kitspace/component_tester/playground/knopf-zelle/Material/besser_als_tischlein.jpg

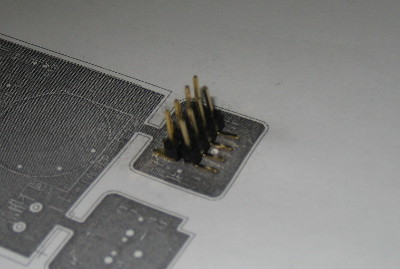
playground/knopf-zelle/Material/besser_als_tischlein.jpg
