kitspace/component_tester/playground/knopf-zelle/Material/Bilder/3top.jpg

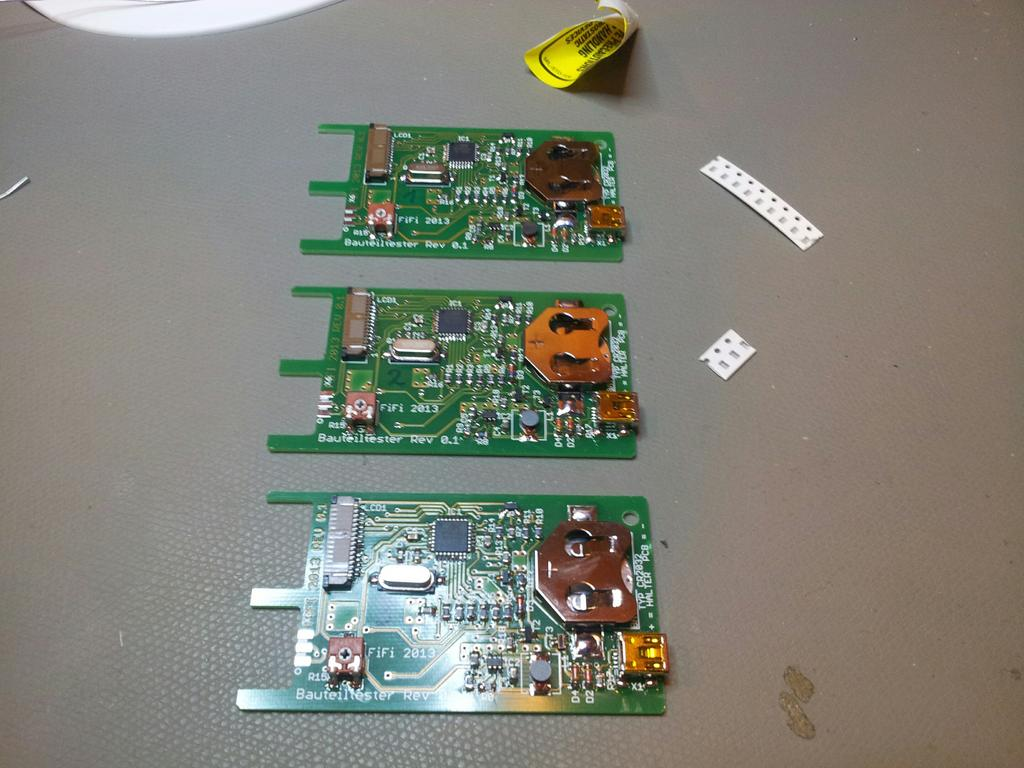
playground/knopf-zelle/Material/Bilder/3top.jpg
