kitspace/component_tester/playground/knopf-zelle/Datasheets/Fischer-SMD-Stiftleiste.jpg

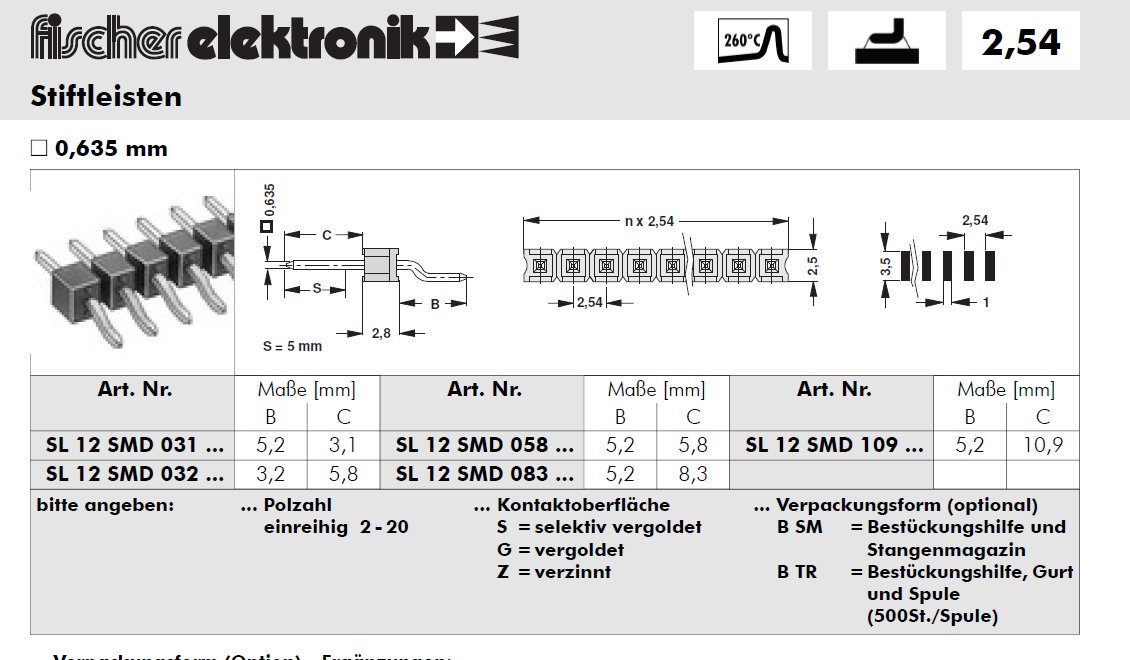
playground/knopf-zelle/Datasheets/Fischer-SMD-Stiftleiste.jpg
