kitspace/component_tester/playground/knopf-zelle/Datasheets/Pollin-Display G120386.JPG

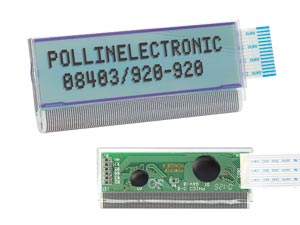
playground/knopf-zelle/Datasheets/Pollin-Display G120386.JPG
