kitspace/component_tester/playground/knopf-zelle/Gehaeuse/Gehaeuse_01.jpg

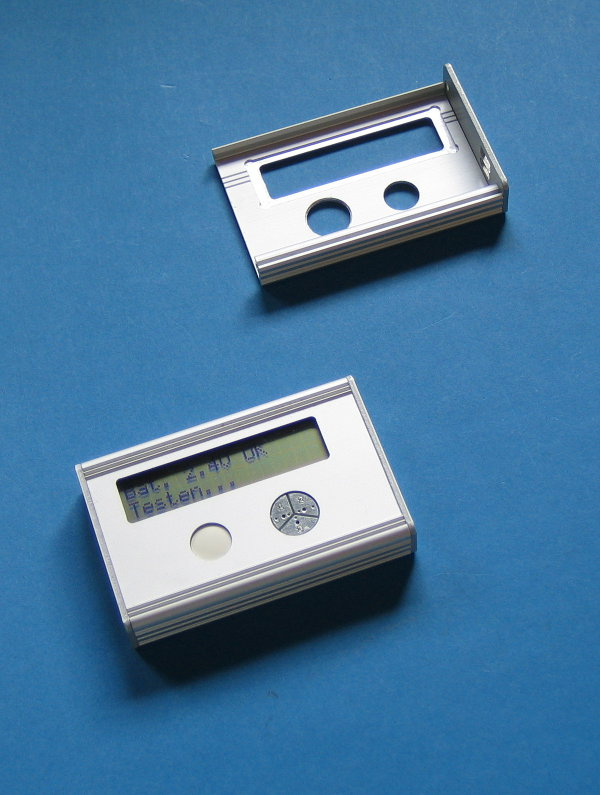
playground/knopf-zelle/Gehaeuse/Gehaeuse_01.jpg
