kitspace/component_tester/playground/knopf-zelle/Material/SMD_Teile.odt

Mini-Bauteiltester Aufbauanleitung: www.ov-lennestadt.de | | | | Mini-Bauteiltester Aufbauanleitung: www.ov-lennestadt.de
6x Varistor 3 pF | 2x 22 pF | 2x 100 nF | 1x 1 nF | 6x Varistor 3 pF | 2x 22 pF | 2x 100 nF | 1x 1 nF
1x 4,7 uF KER | 2x 4,7 uF TAN | 2x 47 uF KER | 1x LED | 1x 4,7 uF KER | 2x 4,7 uF TAN | 2x 47 uF KER | 1x LED
1x LM4040 | 2x 1N4148 | 1x BAS70-05 (C-C) | 1x BAS70-06 (C-A) | 1x LM4040 | 2x 1N4148 | 1x BAS70-05 (C-C) | 1x BAS70-06 (C-A)
1x 100R | 3x 680R 0,1% | 1x 3k3 | 7x 10k +1 | 1x 100R | 3x 680R 0,1% | 1x 3k3 | 7x 10k +1
1x 33k | 1x 68k | 1x 240k | | 1x 33k | 1x 68k | 1x 240k
3x 470k 0,1% | 1x 750k | 1x 1M | 1x 3M3 | 3x 470k 0,1% | 1x 750k | 1x 1M | 1x 3M3
1x BC847 | 1x BSS123 | 1x PMV65XP | 2x BSS84 | 1x BC847 | 1x BSS123 | 1x PMV65XP | 2x BSS84
Lose: Platine, Batteriehalter, Batterie CR2032, 100 uF TAN-D, MEGA 168, MCP1640, LCD, FFC-Buchse, Quarz 8 MHz, Poti 10k, Mini-USB-Buchse, 6p-Steckerwanne, 3p-Stiftleiste SMD | | | | Lose: Platine, Batteriehalter, Batterie CR2032, 100 uF TAN-D, MEGA 168, MCP1640, LCD, FFC-Buchse, Quarz 8 MHz, Poti 10k, Mini-USB-Buchse, 6p-Steckerwanne, 3p-Stiftleiste SMD

Mini-Bauteiltester Aufbauanleitung: www.ov-lennestadt.de | | | | Mini-Bauteiltester Aufbauanleitung: www.ov-lennestadt.de
6x Varistor 3 pF | 2x 22 pF | 2x 100 nF | 1x 1 nF | 6x Varistor 3 pF | 2x 22 pF | 2x 100 nF | 1x 1 nF
1x 4,7 uF KER | 2x 4,7 uF TAN | 2x 47 uF KER | 1x LED | 1x 4,7 uF KER | 2x 4,7 uF TAN | 2x 47 uF KER | 1x LED
1x LM4040 | 2x 1N4148 | 1x BAS70-05 (C-C) | 1x BAS70-06 (C-A) | 1x LM4040 | 2x 1N4148 | 1x BAS70-05 (C-C) | 1x BAS70-06 (C-A)
1x 100R | 3x 680R 0,1% | 1x 3k3 | 7x 10k +1 | 1x 100R | 3x 680R 0,1% | 1x 3k3 | 7x 10k +1
1x 33k | 1x 68k | 1x 240k | | 1x 33k | 1x 68k | 1x 240k
3x 470k 0,1% | 1x 750k | 1x 1M | 1x 3M3 | 3x 470k 0,1% | 1x 750k | 1x 1M | 1x 3M3
1x BC847 | 1x BSS123 | 1x PMV65XP | 2x BSS84 | 1x BC847 | 1x BSS123 | 1x PMV65XP | 2x BSS84
Lose: Platine, Batteriehalter, Batterie CR2032, 100 uF TAN-D, MEGA 168, MCP1640, LCD, FFC-Buchse, Quarz 8 MHz, Poti 10k, Mini-USB-Buchse, 6p-Steckerwanne, 3p-Stiftleiste SMD | | | | Lose: Platine, Batteriehalter, Batterie CR2032, 100 uF TAN-D, MEGA 168, MCP1640, LCD, FFC-Buchse, Quarz 8 MHz, Poti 10k, Mini-USB-Buchse, 6p-Steckerwanne, 3p-Stiftleiste SMD

Es fehlt:

- 4,7 uH Drossel
- Stück 0,6 mm Draht
