kitspace/component_tester/playground/knopf-zelle/Hardware/Bauteilliste.ods

Bauteilliste und Kalkulation Bauteiltester
 |  |  | helltürkis |  |  |  | gelb2
Bauteilcode | Wert | Bauform | Bezugsquelle | Bestell-Bez. / Bemerkung | Preis | bei Menge | Alternativquelle | Bestell-Bez. / Bemerkung | Preis | bei Menge | Anzahl | Preis netto | Preis brutto | Bestand 16.03.14 | Bemerkung
Platine |  | 96x44 | t.b.d. | Leiton | 3.7241 | 100 | t.b.d. |  |  |  | 1 |  |  | 100
BAT1 | Halter CR2032 |  | Mouser | 534-3002 | 0.246 | 100 |  |  |  |  | 1 |  |  | 3
Batterie dafür | CR2032 |  | Pollin | 271034 | 0.5 | 5 | elpro | CR 2032 | 0.302 | 100 | 1 |  |  | 4
C1, C2 | 22p | 0805 | Bestand |  | 0 | 1 | t.b.d. |  |  |  | 2 |  |  | 60 | bitte Rolle
C6 | 100n | 0805 | Bestand |  | 0 | 1 | t.b.d. |  |  |  | 1 |  |  | 600
C3 | 1n | 0805 | Bestand |  | 0 | 1 | t.b.d. |  |  |  | 1 |  |  | 2000
C4, C5 | 47u | 0805 | Mouser | 810-C2012X5R1A476M | 0.322 | 100 | t.b.d. |  |  |  | 2 |  |  | 0
C7 – C12 | 3pF | 0603 | Mouser | 581-VC06AG183R0YAT1A | 0.058 | 100 | t.b.d. |  |  |  | 6 |  |  | 40
C15 | 100u | D | elpro | T-SMD 10 V 100 µF BF: D | 0.28 | 100 |  |  |  |  | 1 |  |  | 40
D1 | LM 4040 AIM3-2,5 | SOT23 | Reichelt | LM 4040 AIM3-2,5 | 0.824 | 1 | t.b.d. |  |  |  | 1 |  |  | 2
D2 | BAV99 | SOT23 | Reichelt | BAV 99 SMD | 0.025 | 1 | t.b.d. |  |  |  | 1 |  |  | 30
D5 | BAS40 | SOT23 | Reichelt | BAS 40-04 SMD | 0.042 | 1 |  |  |  |  | 1 |  |  | 100
IC1 | MEGA8-AI | TQFP32-08 | Mouser | 556-ATMEGA328-AU | 1.3 | 100 | Digi-Key | ATMEGA328-AU-ND | 1.27 | 100 | 1 |  |  | 2 | bitte MEGA 328
IC2 | MCP1640 | SOT23-6 | Mouser | 579-MCP1640TI/CHY | 0.52 | 1 | t.b.d. |  |  |  | 1 |  |  | 1
L1 | 4,7uH | 1210 | Mouser | 81-LQH32CN4R7M33L | 0.16 | 100 | Reichelt | LQH3C 4,7µ | 0.118 | 1 | 1 |  |  | 10
LCD1 |  |  | Pollin | 120386 | 2.48 | 1 | t.b.d. |  |  |  | 1 |  |  | 91 | +3 @1dow
Buchse dafür |  |  | Mouser | 649-SFW14R-2STE1LF | 0.478 | 100 |  |  |  |  | 1 |  |  | 1
Q1 | 8 MHz | HC 49 SMD | Reichelt | 8,0000-HC49-SMD | 0.202 | 1 | t.b.d. |  |  |  | 1 |  |  | 5
R1, R3, R5 | 680R 0,1% | 0805 | elpro | ERA6AEB681V | 0.076 | 100 | Mouser |  |  |  | 3 |  |  | -3 | Fehlbestand!
R7, R12, R13, R16, R17, R18, R19, R20 | 10k | 0805 | Bestand |  | 0 |  | t.b.d. |  |  |  | 8 |  |  | 1000
R14 | 47k | 0805 | elpro | 0805-SMD 1% 47 k | 0.0013 | 5000 | Mouser | 603-RC0805FR-0747KL | 0.002 | 5000 | 1 |  |  | 4000
R9 | 240k | 0805 | Bestand |  | 0 |  |  |  |  |  | 1 |  |  | 3500
R10 | 1M | 0805 | Bestand |  | 0.0013 | 5000 |  |  |  |  | 1 |  |  | 3000
R2, R4, R6 | 470k 0,1% | 0805 | elpro | ERA6AEB474V | 0.076 | 100 |  |  |  |  | 3 |  |  | 20
R8 | 750k | 0805 | elpro | 0805-SMD 1% 750 k | 0.0013 | 5000 | Mouser | 71-CRCW0805-750K-E3 |  |  | 1 |  |  | 4000
R11 | 330k | 0805 | elpro | 0805-SMD 1% 330 k | 0.00252 | 5000 | Mouser | 603-RC0805FR-07330KL | 0.002 | 5000 | 1 |  |  | 4000
R15 | Poti 10k |  | Reichelt | ACP 6-SMD 10k | 0.227 | 1 | t.b.d. |  |  |  | 1 |  |  | 1
SW1 |  | 8x8 | Reichelt | RAFI 100.503 | 0.378 | 1 | t.b.d. |  |  |  | 1 |  |  | 1
Kappe dafür |  |  | Reichelt | RAFI 167.227 | 0.075 | 1 | t.b.d. |  |  |  | 1 |  |  | 1
T1 | BC847 | SOT23 | Reichelt | BC 847C SMD | 0.0336 | 1 | t.b.d. |  |  |  | 1 |  |  | 100
T2 | BSS123 | SOT23 | Reichelt | BSS 123 SMD | 0.042 | 1 | t.b.d. |  |  |  | 1 |  |  | 80
T3 | PMV65XP | SOT23 | Mouser | 771-PMV65XP-T/R | 0.223 | 100 |  |  |  |  | 1 |  |  | 20
T5 | BSS84 | SOT23 | Reichelt | BSS 84P SMD | 0.042 | 1 |  |  |  |  | 1 |  |  | 100
X1 | USB-Buchse | Mini-USB Print | Reichelt | USB BWM SMD | 0.201 | 1 |  |  |  |  | 1 |  |  | 1
X2, X7, X8 | Loch |  |  |  | 0 |  |  |  |  |  | 3 |  |  | -
X3, X4, X5 | Draht 0,6 mm CuAg | 2,54 mm | Reichelt | SILBER 0,6MM | 1.76 | 1 |  |  |  |  | 0.01 |  |  | 0 | Bitte 1 Rolle
X6 | Steckerwanne 2x3 | 2,54 mm | Reichelt | WSL 6G | 0.134 | 1 | Pollin | 451166 |  |  | 1 |  |  | 0
X9 | Stifte 3x1 Winkel SMD | 2,54 mm | Reichelt | SL 1X40W SMD2,54 | 0.164 | 1 |  |  |  |  | 0.1 |  |  | 0 | Achtung 10=1
 |  |  |  |  |  |  | t.b.d.
SUMME
Optionen
Gehäuse |  | 55x80x16 | Reichelt | AKG 55 80 16 ME | 7.395 | 1 | t.b.d. |  |  |  | 1 |  |  | 100
C13 | 100n | 0805 | Bestand |  | 0 | 1 |  |  |  |  | 1 |  |  | s.o.
C16, C17 | 4,7u | A | elpro | T-SMD 16 V 4,7 µF BF: A | 0.07 | 100 |  |  |  |  | 2 |  |  | 3
IC3 | MAX 1811 | SO-8 | Reichelt | MAX 1811 ESA | 2.563 | 1 |  |  |  |  | 1 |  |  | 0
IC4 | FT232 | 28-SSOP | Mouser | 895-FT232RL | 4.8 | 1 |  |  |  |  | 1 |  |  | 0
LED1 | rot | 0805 | Reichelt | SMD-LED 0805 RT | 0.067 | 1 |  |  |  |  | 1 |  |  | 0
R22 | 100R | 0805 | Bestand |  | 0.0013 | 5000 |  |  |  |  | 1 |  |  | Rolle
T4 | BSS123 | SOT23 | Reichelt | BSS 123 SMD | 0.042 | 1 |  |  |  |  | 1 |  |  | s.o.
Alle Preise in farblich unterlegten Feldern sind netto!
