kitspace/component_tester/playground/knopf-zelle/Material/Bilder/BTT_Dez12_22 006ck.jpg

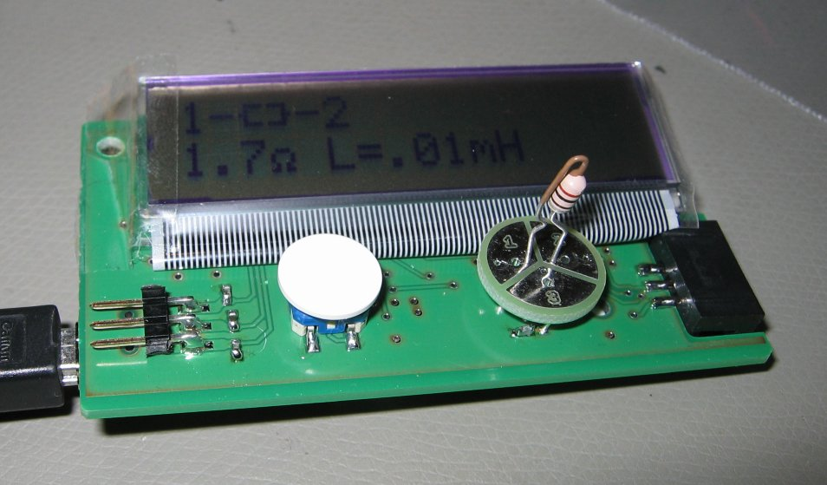
playground/knopf-zelle/Material/Bilder/BTT_Dez12_22 006ck.jpg
