kitspace/component_tester/playground/knopf-zelle/Material/Modifikationen_SCH.jpg

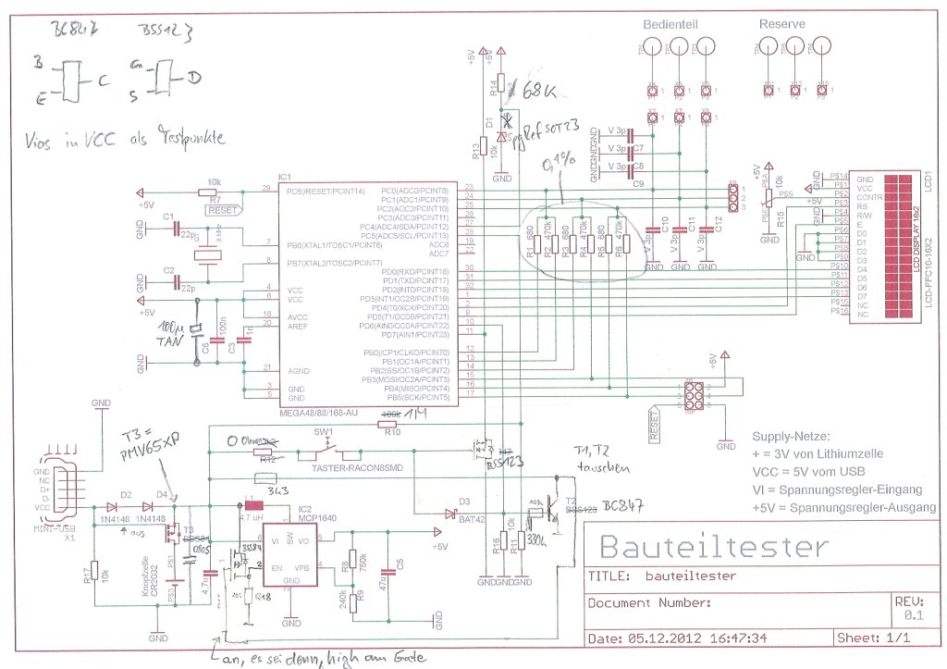
playground/knopf-zelle/Material/Modifikationen_SCH.jpg
