kitspace/component_tester/playground/knopf-zelle/Material/Tischlein.jpg

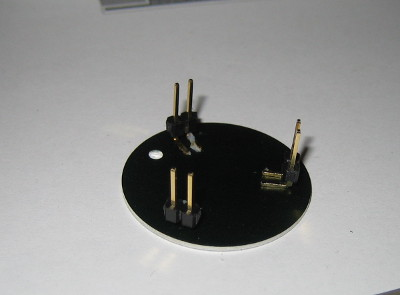
playground/knopf-zelle/Material/Tischlein.jpg
