kitspace/component_tester/playground/knopf-zelle/Gehaeuse/Frontplatte_Rueck_Rev02.dxf

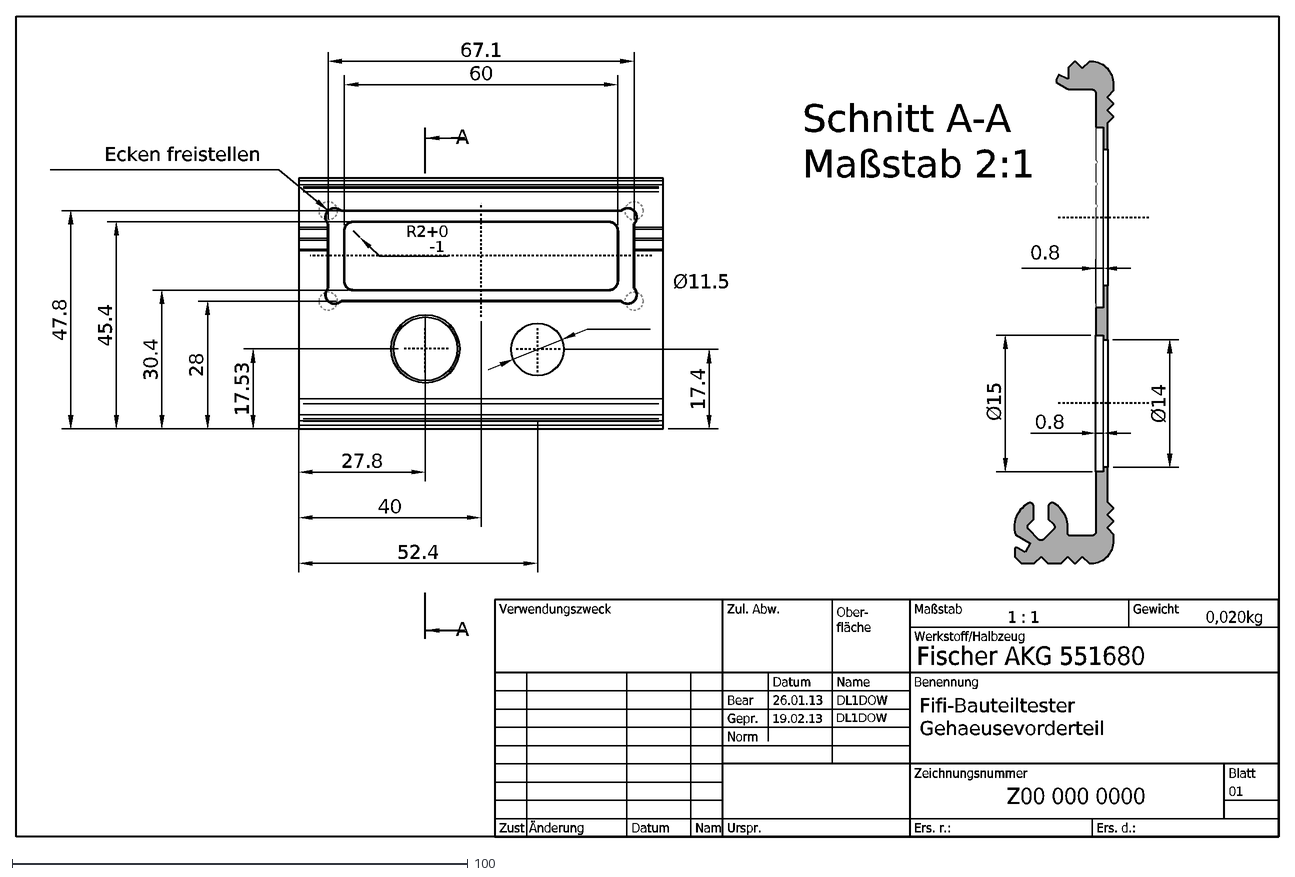
[picture p84: CAD file, 2020-09-11]
playground/knopf-zelle/Gehaeuse/Frontplatte_Rueck_Rev02.dxf
A
Schnitt A-A Maßstab 2:1
60
67.1
27.8
52.4
40
28
45.4
47.8
17.4
17.53
30.4
Ø11.5
Ø14
Ø15
0.8
R2+0^-1
Ecken freistellen
Verwendungszweck
Zul. Abw.
Ober- fläche
Maßstab
Gewicht
Werkstoff/Halbzeug
Benennung
Zeichnungsnummer
Ers. r.:
Ers. d.:
Blatt
Zust
Änderung
Datum
Nam
Urspr.
Name
Bear
Gepr.
Norm
26.01.13
DL1DOW
Z00 000 0000
01
1 : 1
0,020kg
Fischer AKG 551680
Fifi-Bauteiltester Gehaeusevorderteil
19.02.13
