kitspace/component_tester/playground/knopf-zelle/Gehaeuse/Fischer_AKG551680.dxf

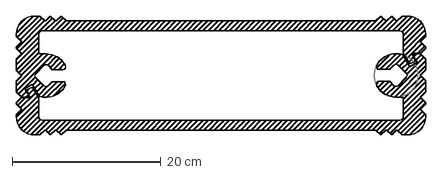
[picture p85: CAD file, 2020-09-11]
playground/knopf-zelle/Gehaeuse/Fischer_AKG551680.dxf
55.0 x 16.0 cm
