kitspace/component_tester/playground/knopf-zelle/Gehaeuse/Seitenplatte_vorn_Rev02.dxf

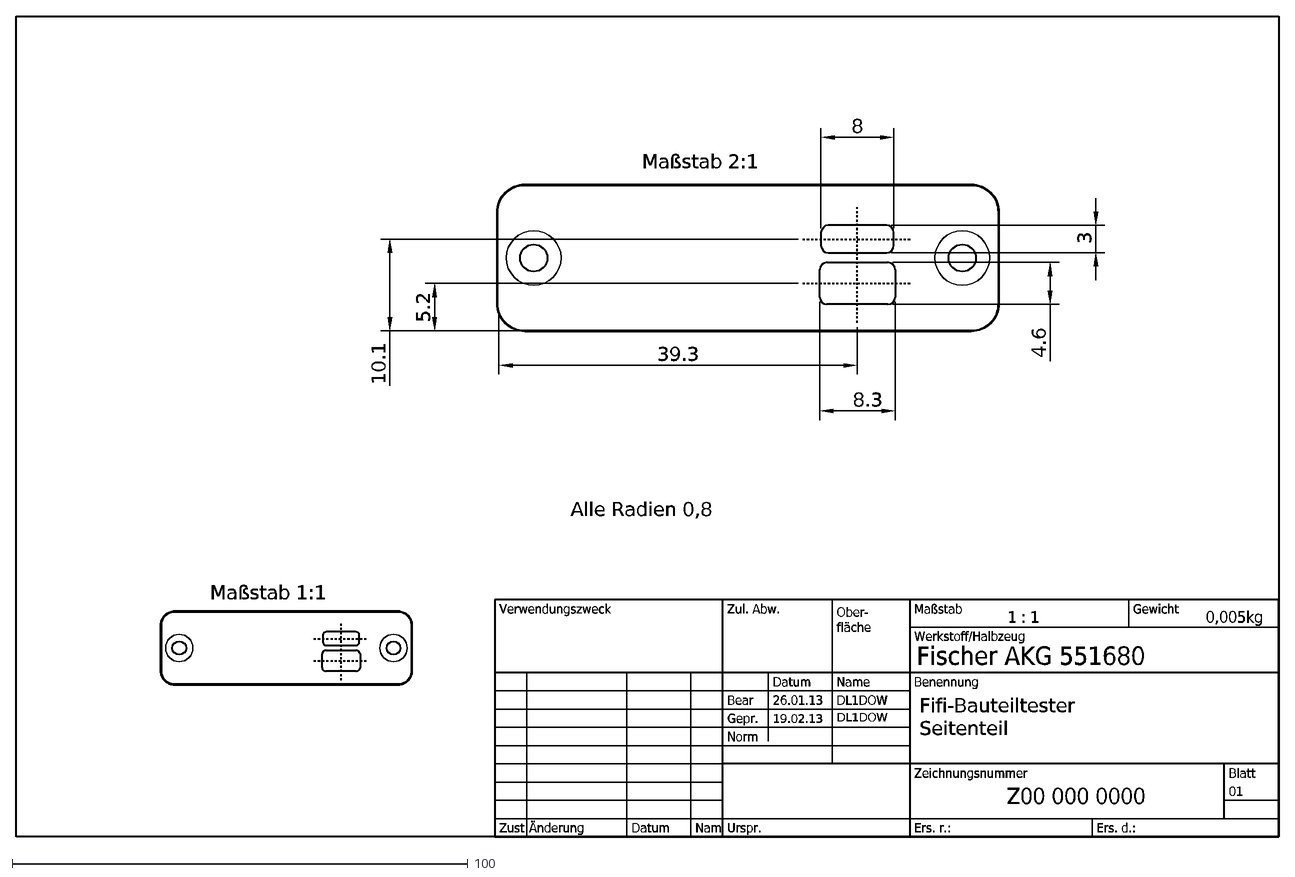
[picture p86: CAD file, 2020-09-11]
playground/knopf-zelle/Gehaeuse/Seitenplatte_vorn_Rev02.dxf
Verwendungszweck
Zul. Abw.
Ober- fläche
Maßstab
Gewicht
Werkstoff/Halbzeug
Benennung
Zeichnungsnummer
Ers. r.:
Ers. d.:
Blatt
Zust
Änderung
Datum
Nam
Urspr.
Name
Bear
Gepr.
Norm
26.01.13
DL1DOW
Z00 000 0000
01
1 : 1
0,005kg
Fischer AKG 551680
Fifi-Bauteiltester Seitenteil
Alle Radien 0,8
8
8.3
4.6
3
39.3
5.2
10.1
Maßstab 2:1
Maßstab 1:1
19.02.13
