kitspace/component_tester/(list of files, cad)

Other CAD files:
playground/knopf-zelle/Gehaeuse/Frontplatte_Rueck.dxf
playground/knopf-zelle/Gehaeuse/Seitenplatte_Vor.dxf
