kitspace/component_tester/playground/knopf-zelle/Material/Überlegung-Selbsthaltung ohne 90% Problem.png

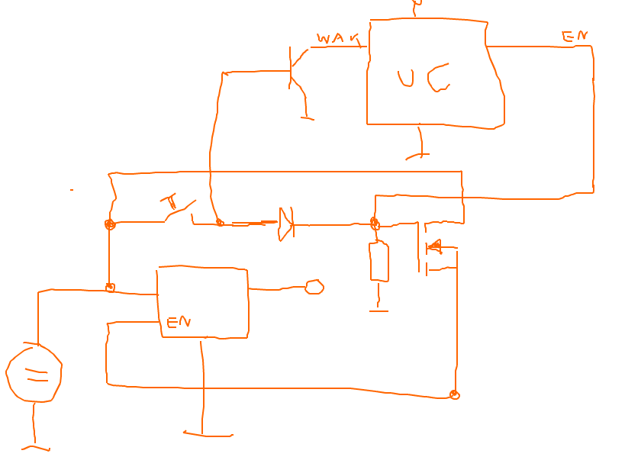
playground/knopf-zelle/Material/Überlegung-Selbsthaltung ohne 90% Problem.png
