kitspace/component_tester/playground/SBMS_HW/SBMS120_v03d/main-pcb-120/SBMS120.pdf

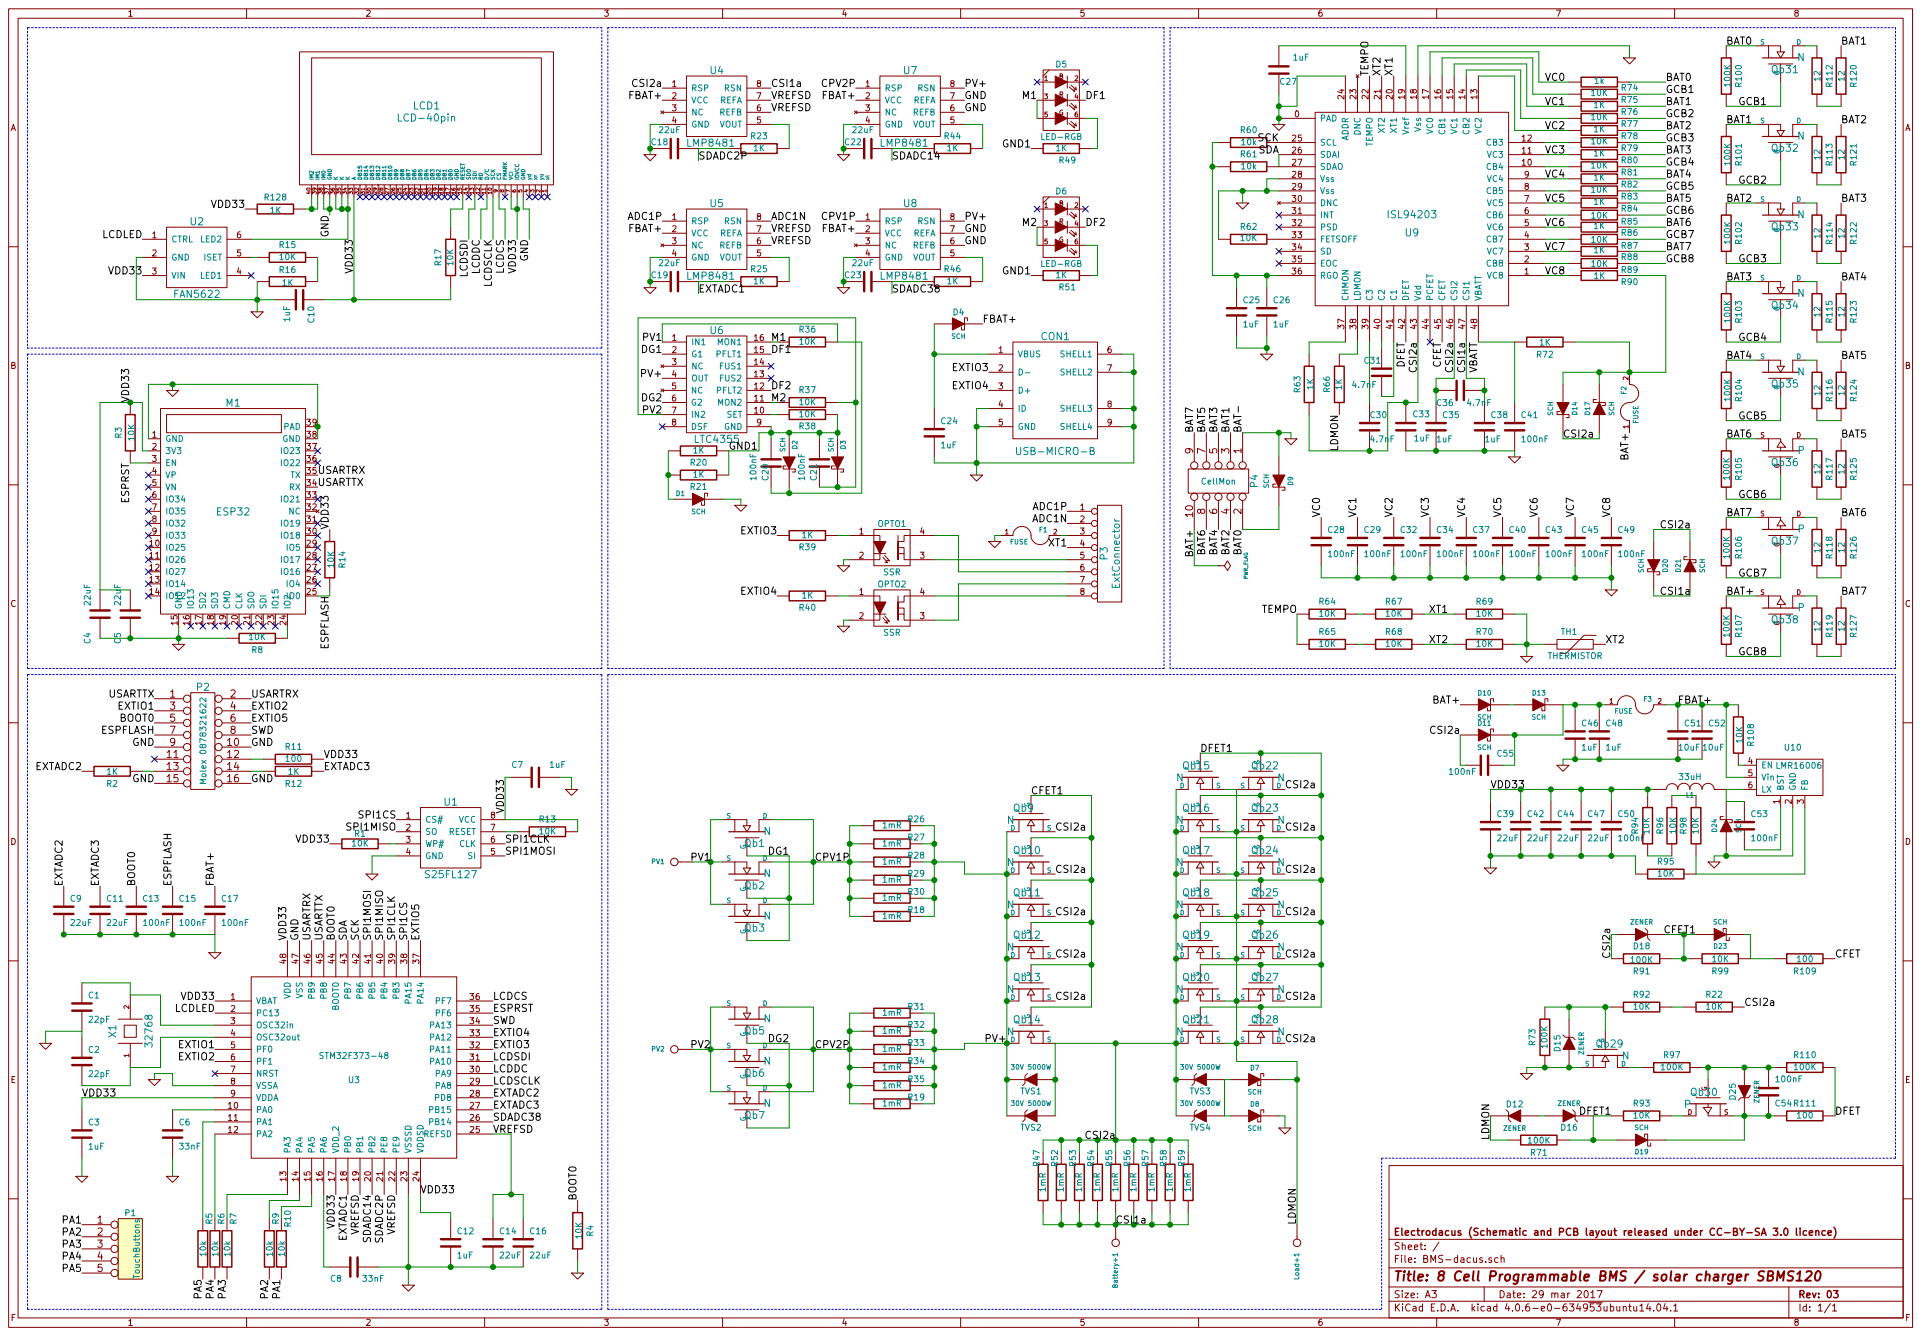
[picture p103: page 1]

9 SCK 10 DB3 20 DB13 30 IM2 40 D/C 11 DB4 21 DB14 31 RD 12 DB5 22 DB15 32 SDI 13 DB6 23 A 33 SDO 14 DB7 24 K 34 RESET 15 DB8 25 K 35 GND 16 DB9 26 K 36 DB0 17 DB10 27 GND 37 DB1 18 DB11 28 IM0 38 DB2 19 DB12 29 IM1 39 LCD1

File: BMS-dacus.sch Sheet: / Electrodacus (Schematic and PCB layout released under CC-BY-SA 3.0 licence)

Id: 1/1 Title: 8 Cell Programmable BMS / solar charger SBMS120
