kitspace/component_tester/playground/knopf-zelle/Hardware/bauteiltester_bot.pdf

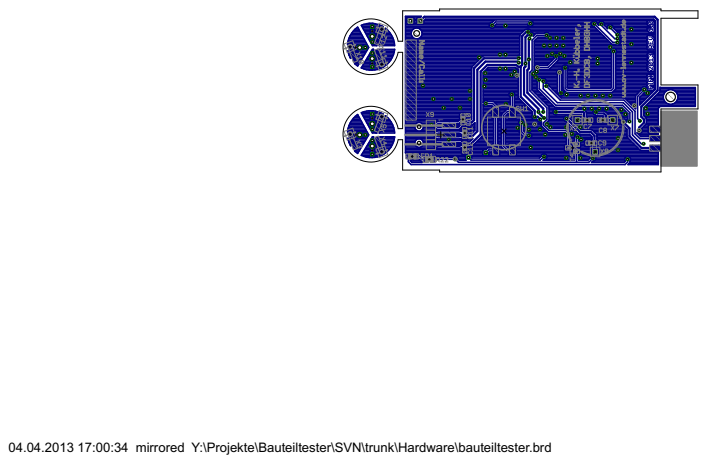
[picture p104: page 1]

04.04.2013 17:00:34 mirrored Y:\Projekte\Bauteiltester\SVN\trunk\Hardware\bauteiltester.brd
