kitspace/component_tester/playground/knopf-zelle/Hardware/bauteiltester_brd.pdf

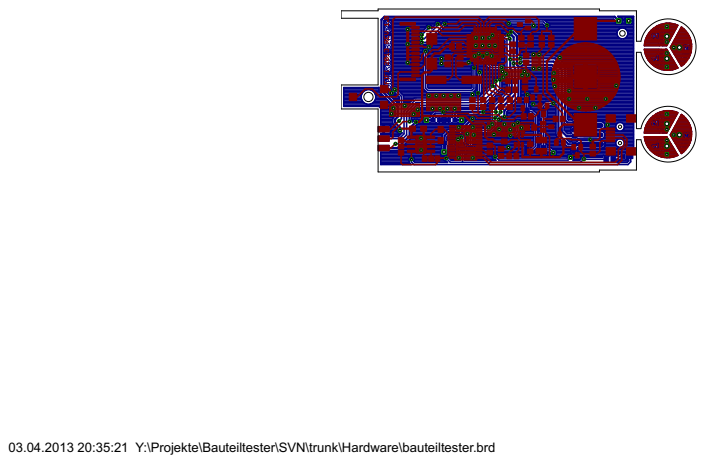
[picture p105: page 1]

03.04.2013 20:35:21 Y:\Projekte\Bauteiltester\SVN\trunk\Hardware\bauteiltester.brd
