kitspace/component_tester/playground/knopf-zelle/Hardware/bauteiltester_modul_BOT.pdf

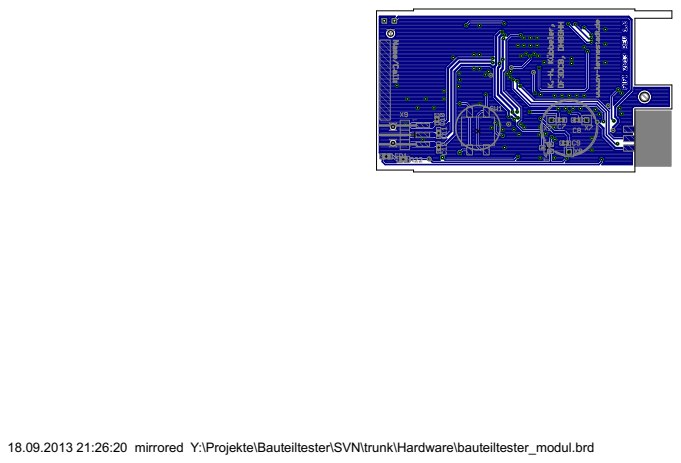
[picture p106: page 1]

18.09.2013 21:26:20 mirrored Y:\Projekte\Bauteiltester\SVN\trunk\Hardware\bauteiltester_modul.brd
