kitspace/component_tester/playground/knopf-zelle/Hardware/bauteiltester_modul_BRD.pdf

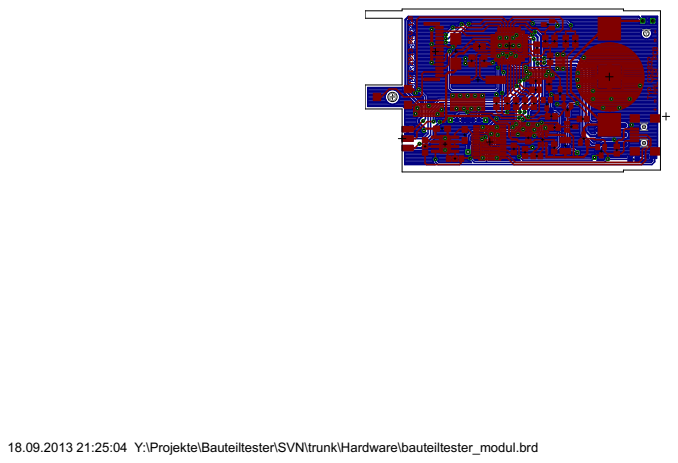
[picture p107: page 1]

18.09.2013 21:25:04 Y:\Projekte\Bauteiltester\SVN\trunk\Hardware\bauteiltester_modul.brd
