kitspace/component_tester/playground/knopf-zelle/Hardware/bauteiltester_modul_SCH.pdf

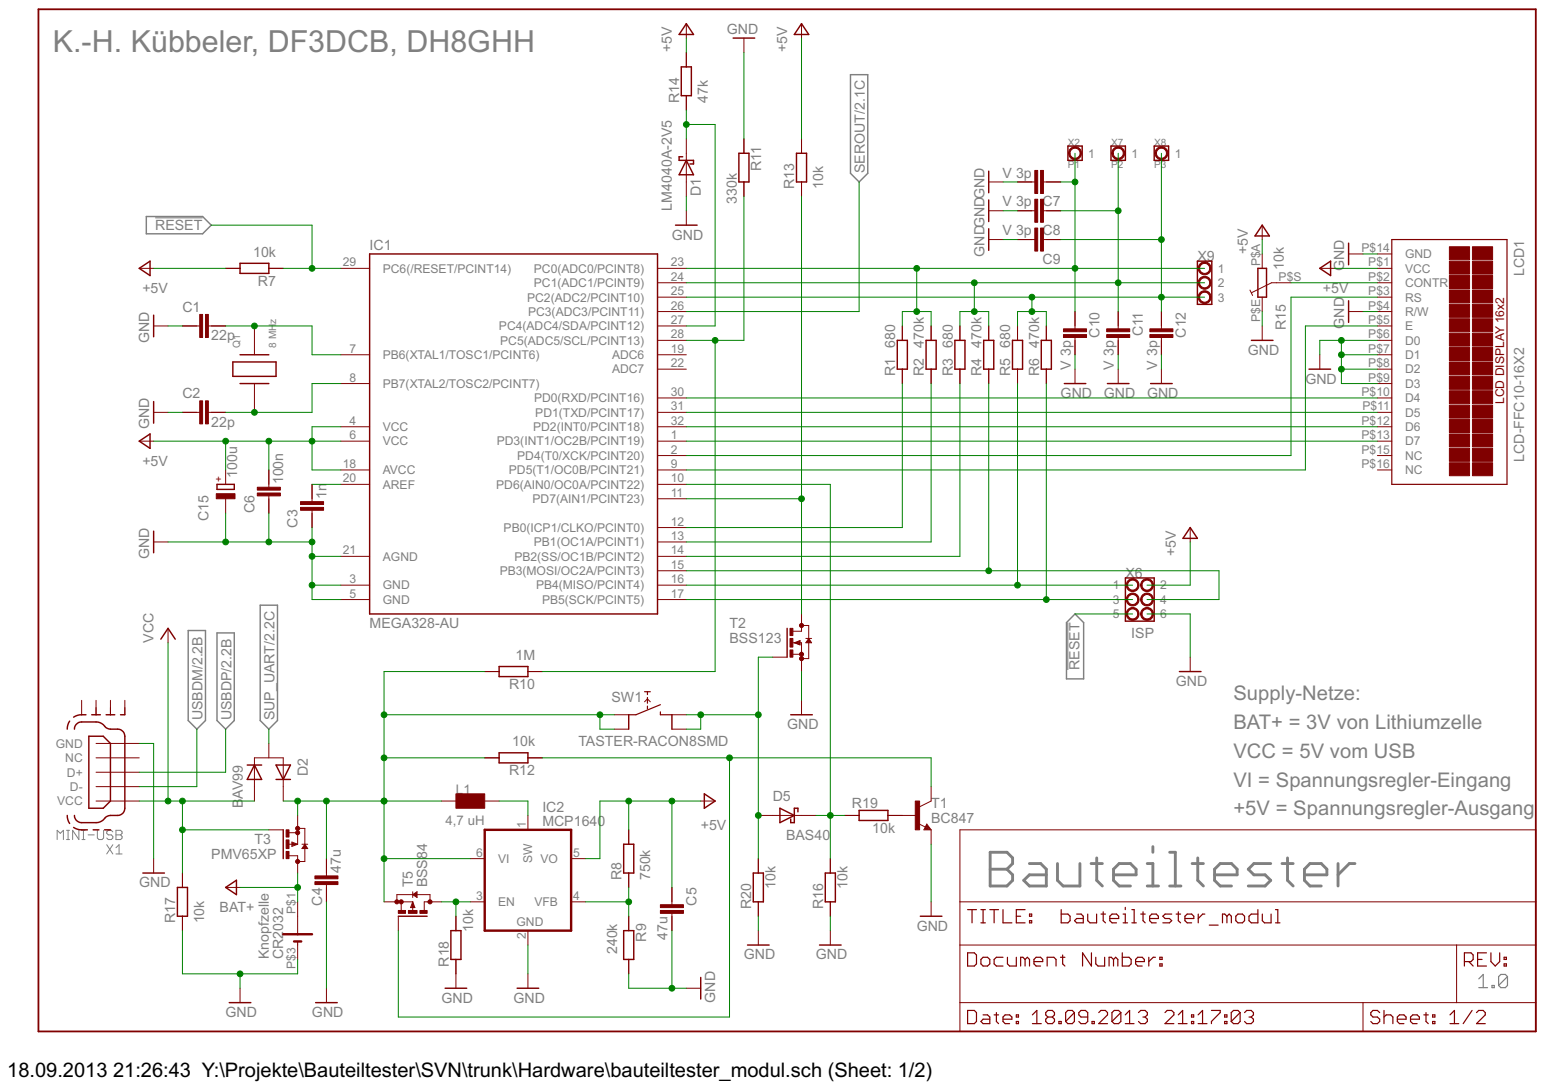
[picture p108: page 1]

18.09.2013 21:26:43 Y:\Projekte\Bauteiltester\SVN\trunk\Hardware\bauteiltester_modul.sch (Sheet: 1/2)

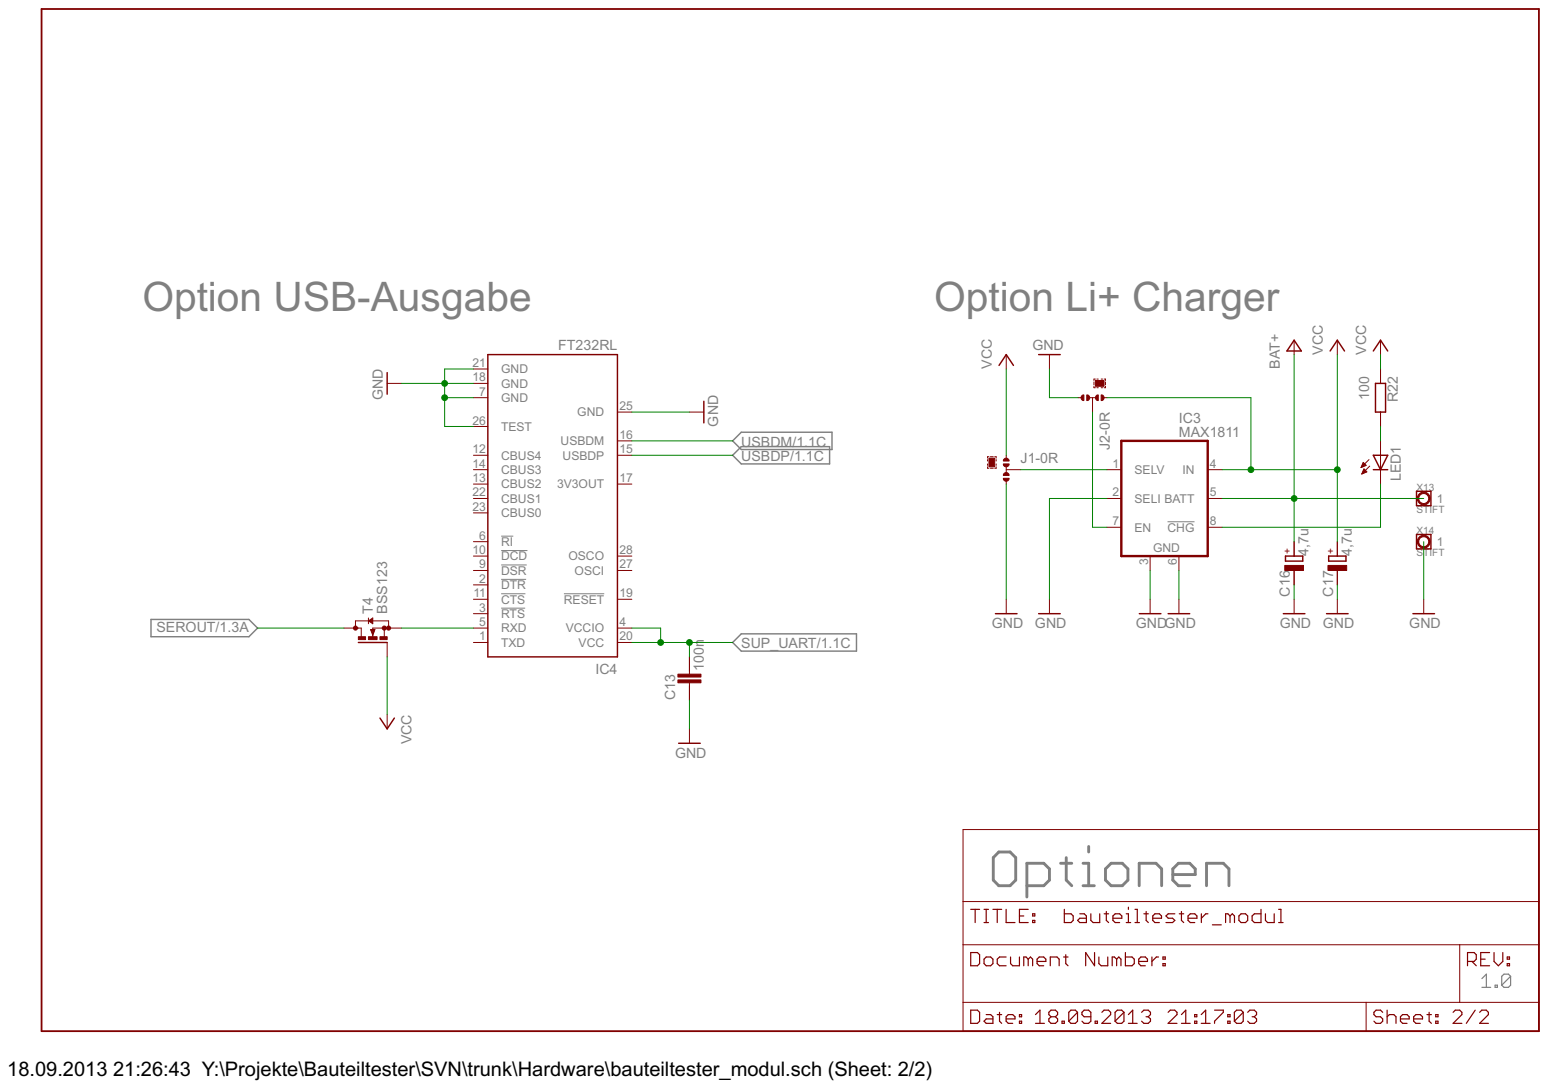
[picture p109: page 2]

18.09.2013 21:26:43 Y:\Projekte\Bauteiltester\SVN\trunk\Hardware\bauteiltester_modul.sch (Sheet: 2/2)
