kitspace/component_tester/playground/knopf-zelle/Hardware/bauteiltester_modul_TOP.pdf

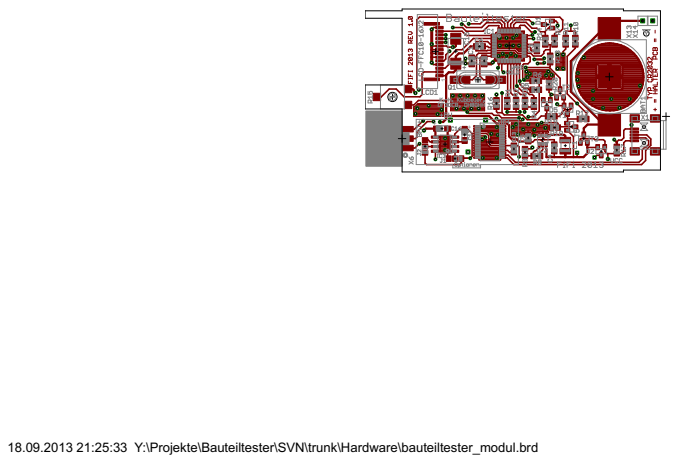
[picture p110: page 1]

18.09.2013 21:25:33 Y:\Projekte\Bauteiltester\SVN\trunk\Hardware\bauteiltester_modul.brd
