kitspace/component_tester/playground/knopf-zelle/Hardware/bauteiltester_sch.pdf

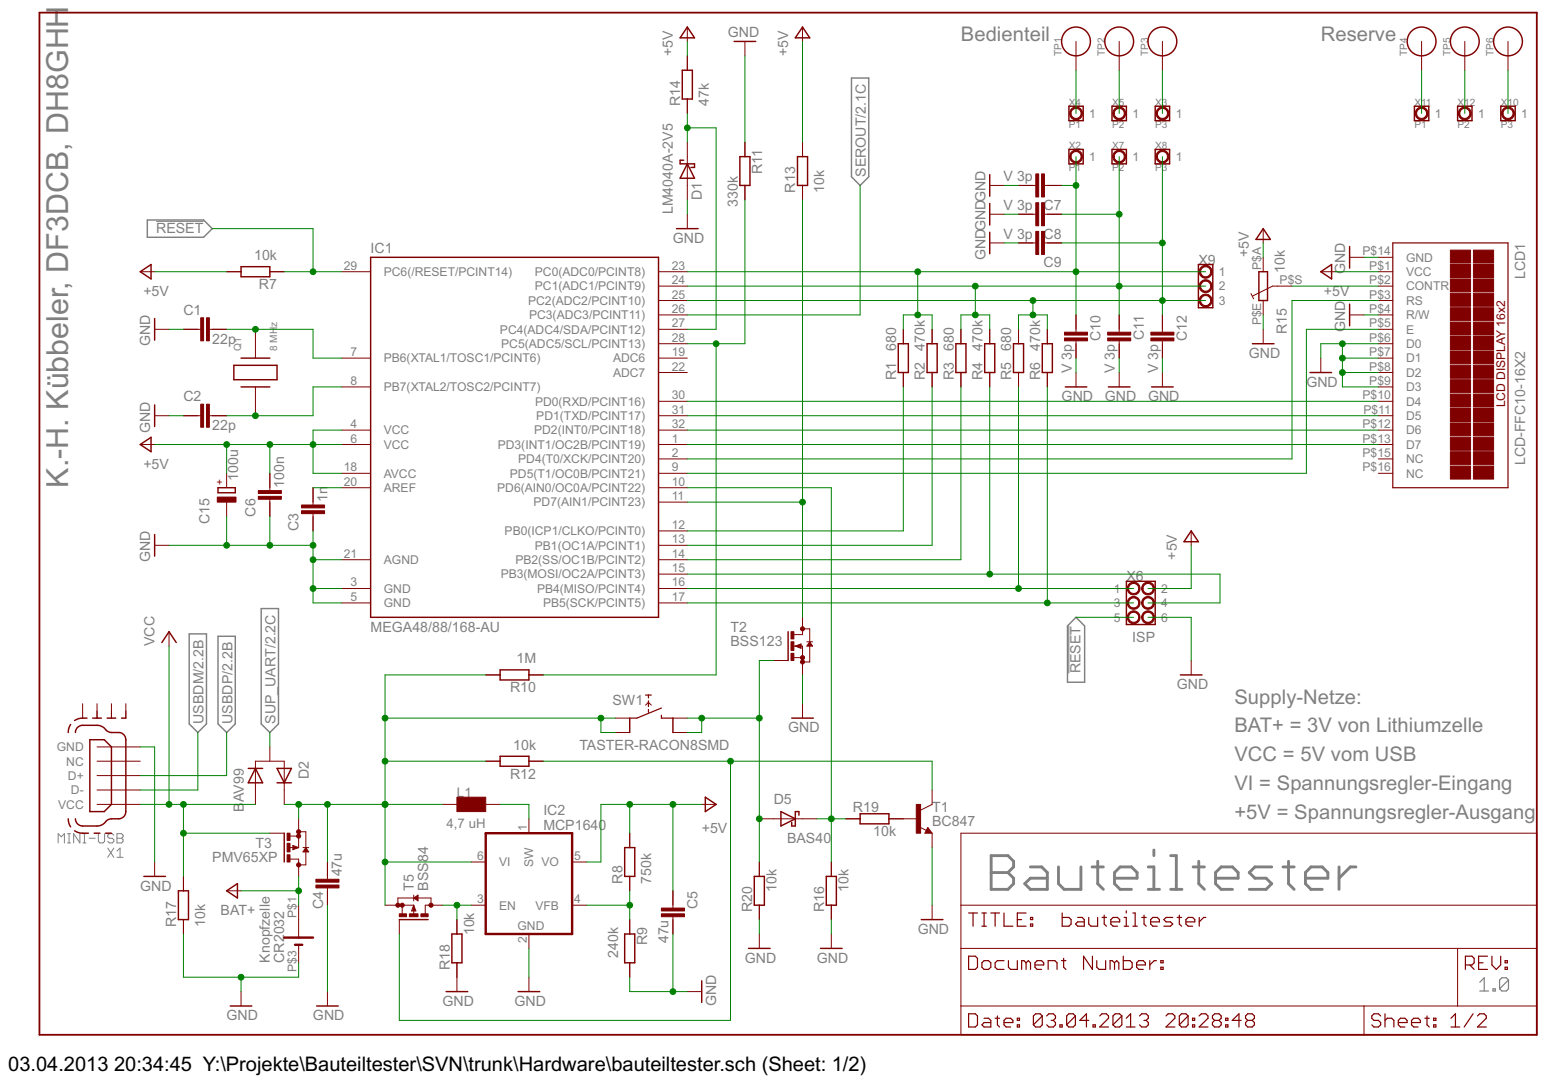
[picture p111: page 1]

03.04.2013 20:34:45 Y:\Projekte\Bauteiltester\SVN\trunk\Hardware\bauteiltester.sch (Sheet: 1/2)

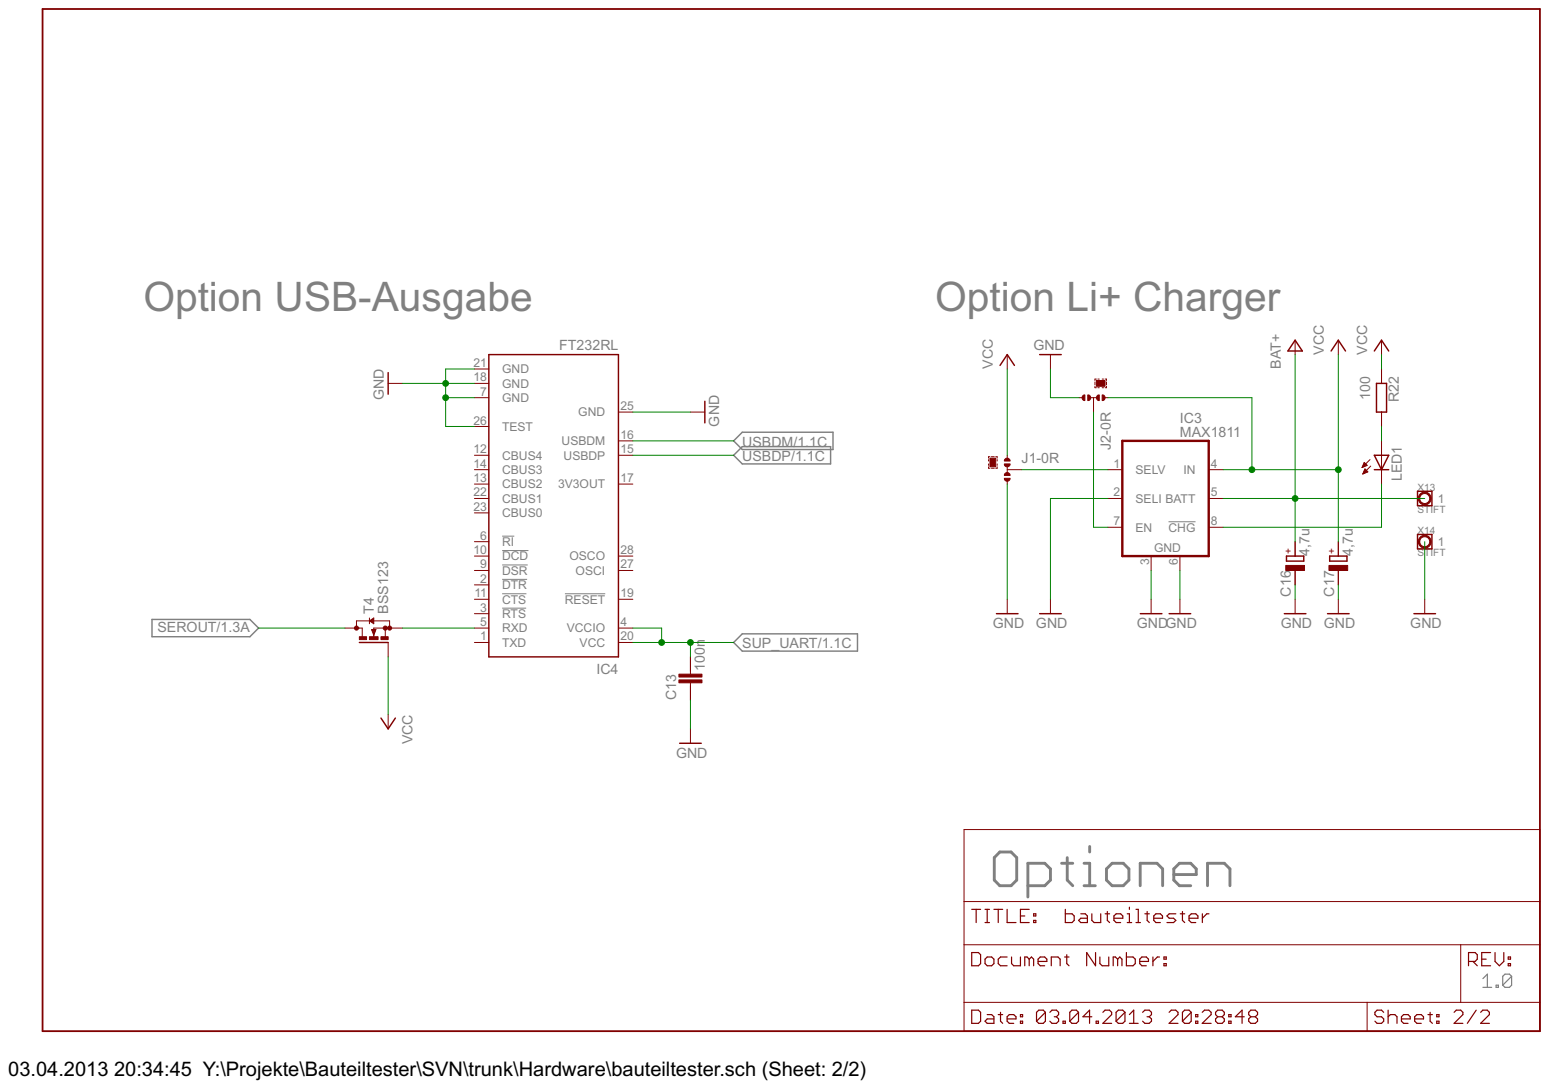
[picture p112: page 2]

03.04.2013 20:34:45 Y:\Projekte\Bauteiltester\SVN\trunk\Hardware\bauteiltester.sch (Sheet: 2/2)
