kitspace/component_tester/playground/knopf-zelle/Hardware/bauteiltester_sensor_BOT.pdf

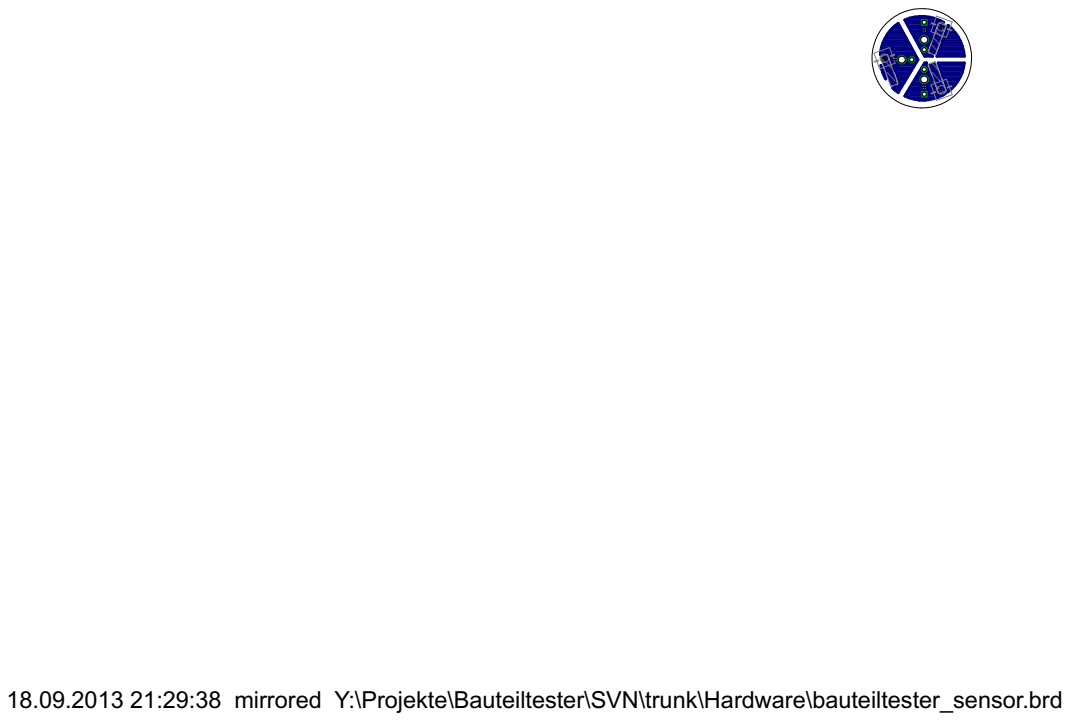
[picture p113: page 1]

18.09.2013 21:29:38 mirrored Y:\Projekte\Bauteiltester\SVN\trunk\Hardware\bauteiltester_sensor.brd
