kitspace/component_tester/playground/knopf-zelle/Hardware/bauteiltester_sensor_BRD.pdf

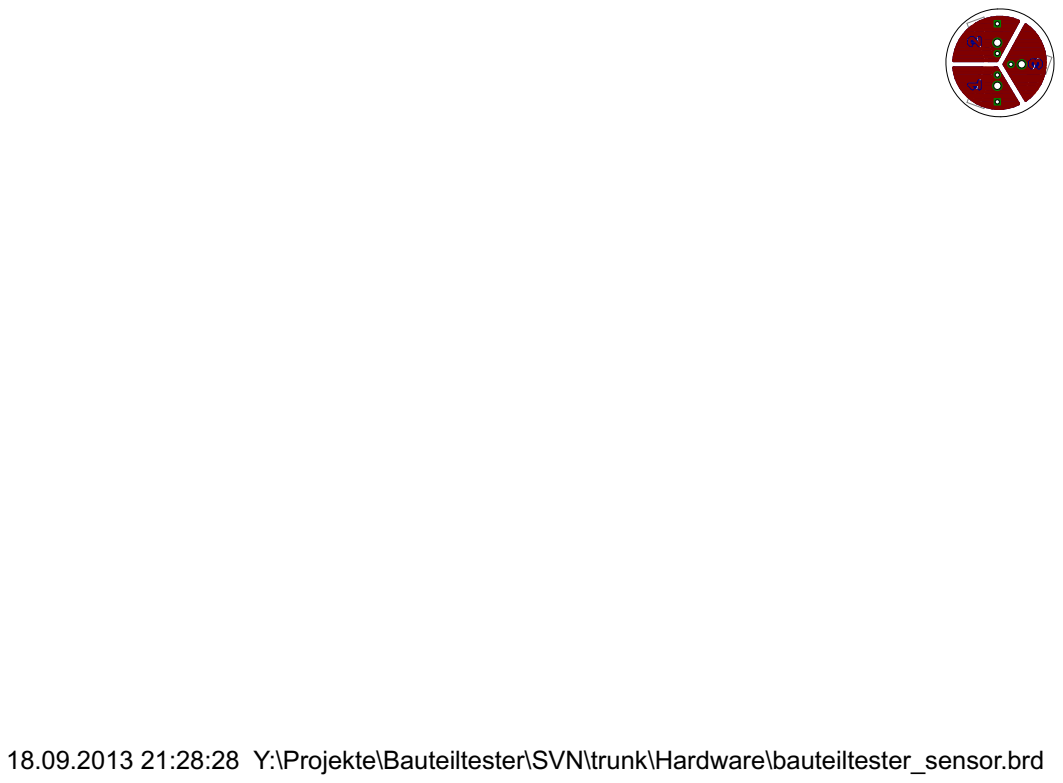
[picture p114: page 1]

18.09.2013 21:28:28 Y:\Projekte\Bauteiltester\SVN\trunk\Hardware\bauteiltester_sensor.brd
