kitspace/component_tester/playground/knopf-zelle/Hardware/bauteiltester_sensor_SCH.pdf

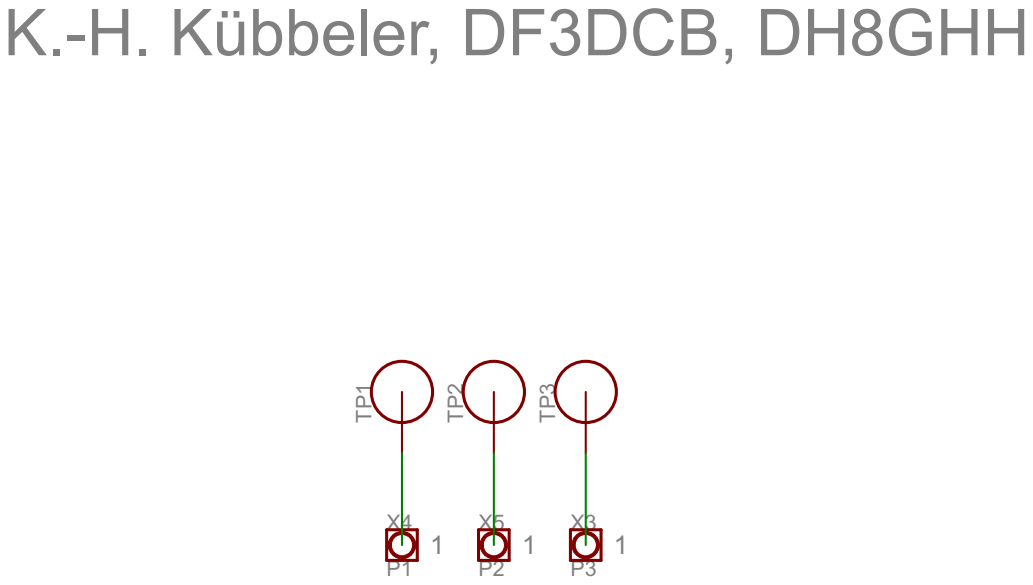
[picture p115: page 1]

18.09.2013 21:30:12 Y:\Projekte\Bauteiltester\SVN\trunk\Hardware\bauteiltester_sensor.sch (Sheet: 1/1)
