kitspace/component_tester/playground/knopf-zelle/Hardware/bauteiltester_sensor_TOP.pdf

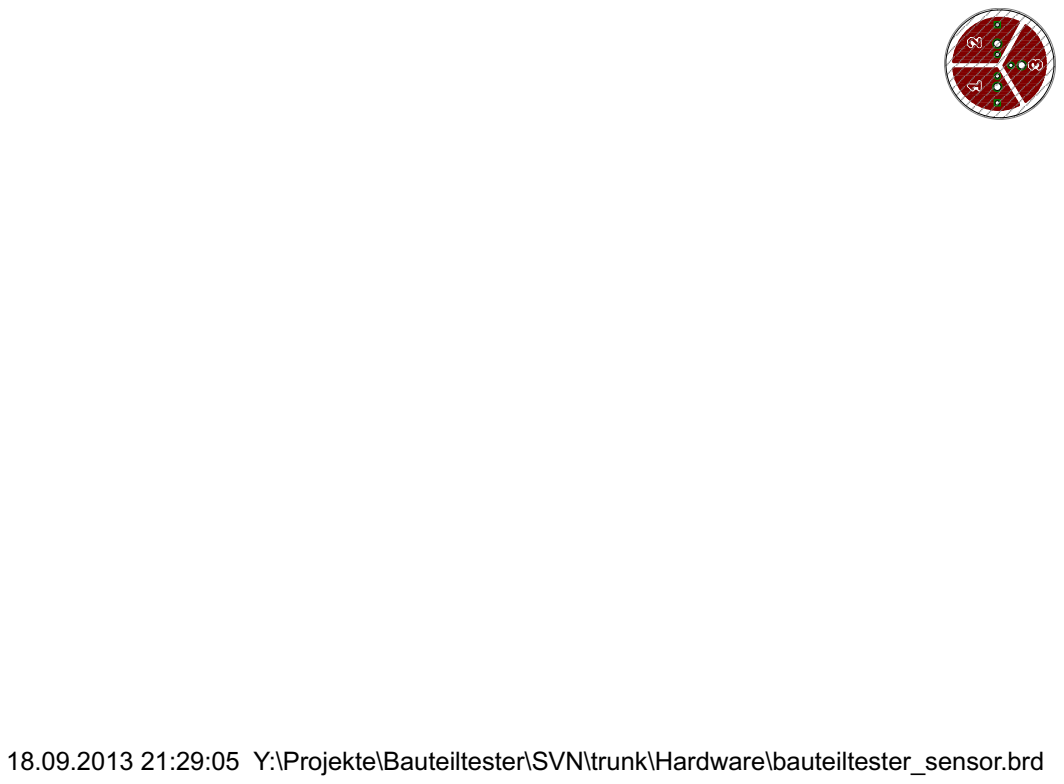
[picture p116: page 1]

18.09.2013 21:29:05 Y:\Projekte\Bauteiltester\SVN\trunk\Hardware\bauteiltester_sensor.brd
