kitspace/component_tester/playground/knopf-zelle/Hardware/bauteiltester_top.pdf

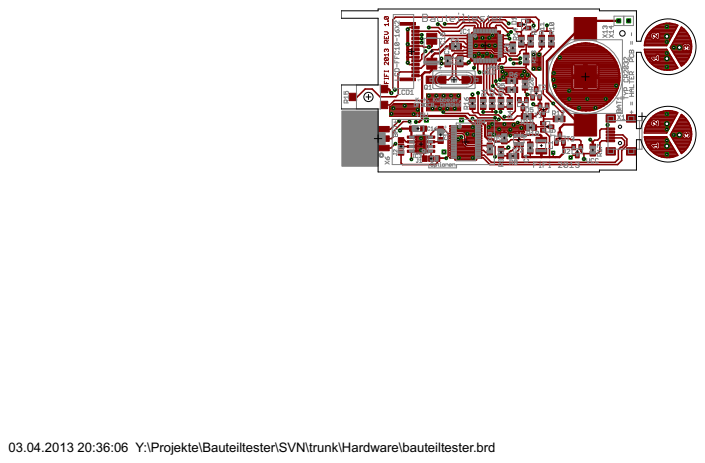
[picture p117: page 1]

03.04.2013 20:36:06 Y:\Projekte\Bauteiltester\SVN\trunk\Hardware\bauteiltester.brd
