kitspace/component_tester/playground/knopf-zelle/Gehaeuse/Frontplatte_Rueck_Rev02.pdf

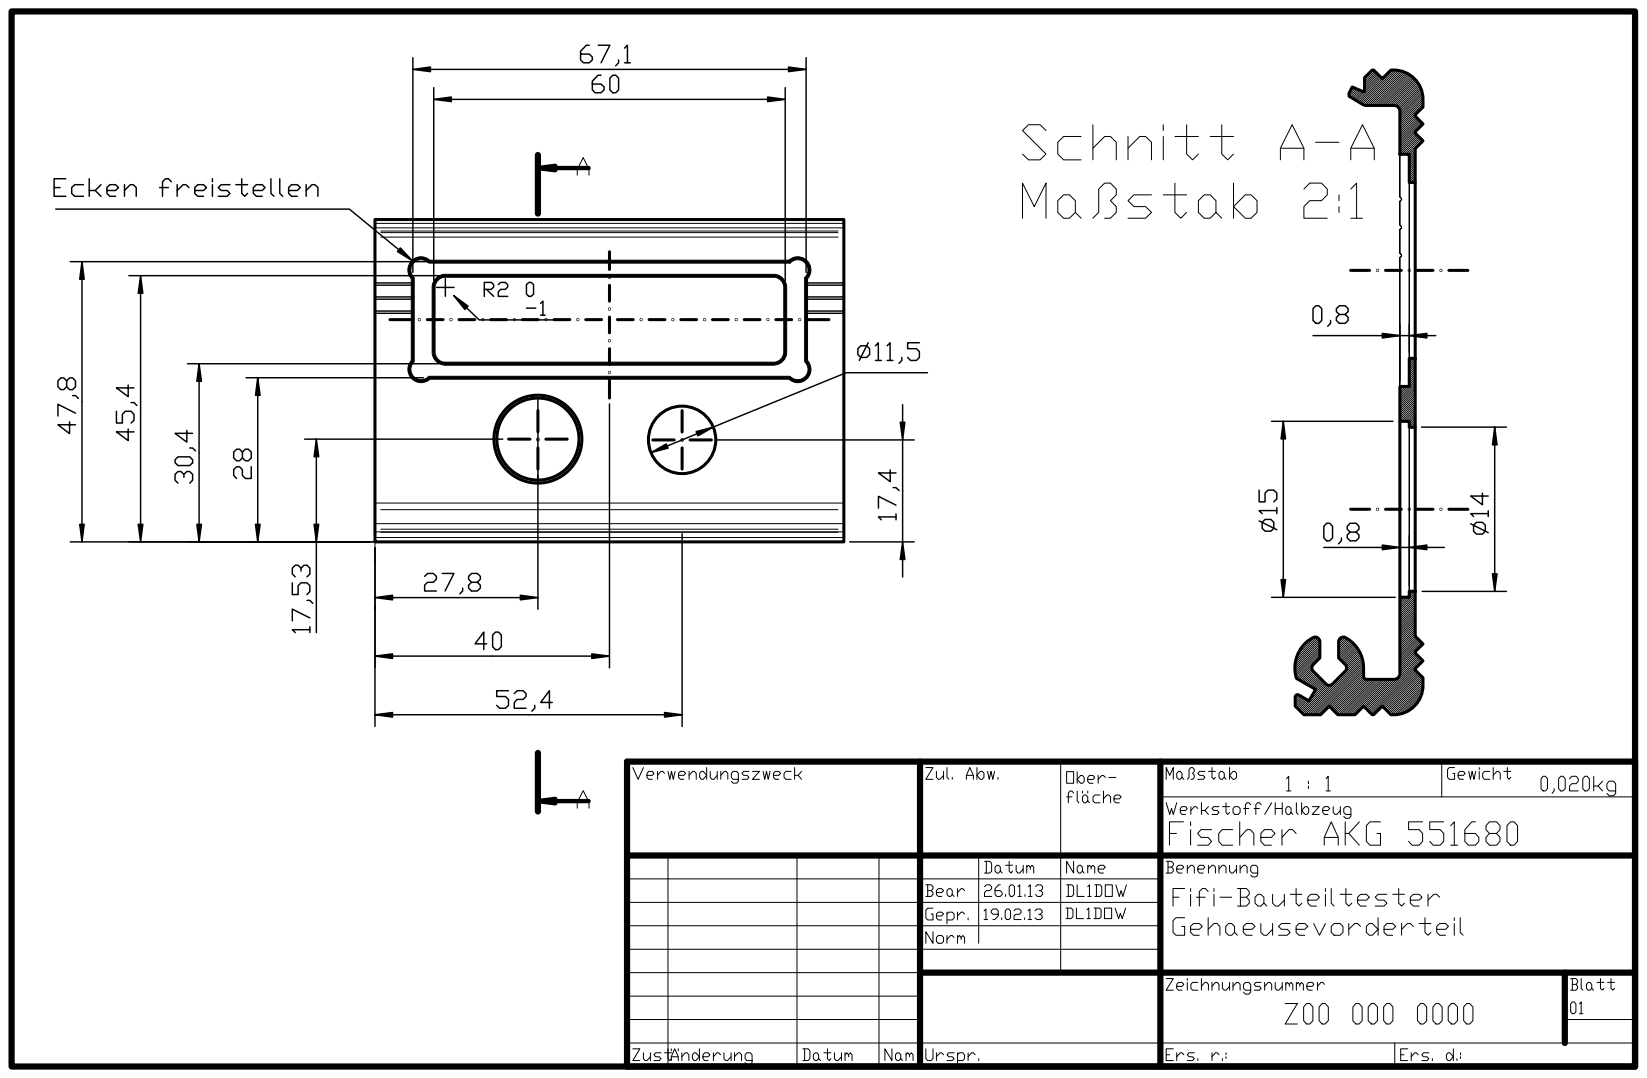
[picture p118: page 1]
