kitspace/component_tester/playground/knopf-zelle/Gehaeuse/Seitenplatte_vorn_Rev02.pdf

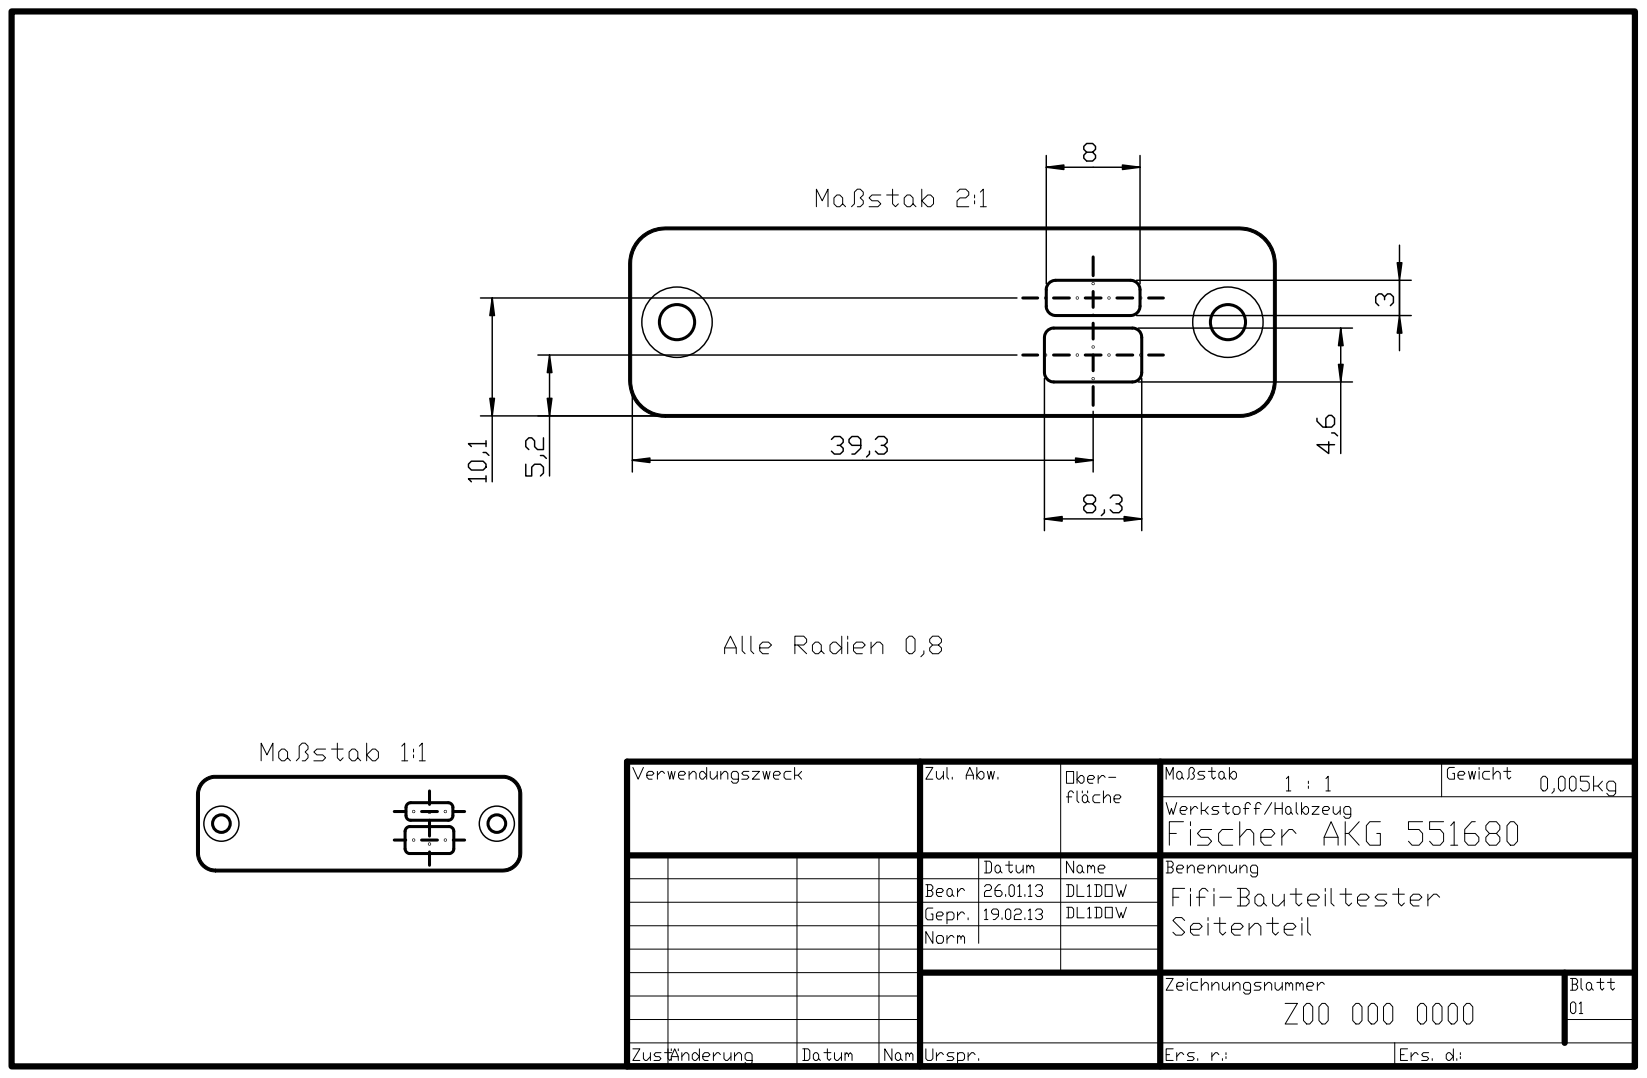
[picture p119: page 1]
