kitspace/component_tester/playground/SBMS_HW/SBMS40_v02c/main-pcb-40/BMS-dacus.kicad_pcb

## KiCad design playground/SBMS_HW/SBMS40_v02c/main-pcb-40/BMS-dacus.kicad_pcb (2020-09-11)

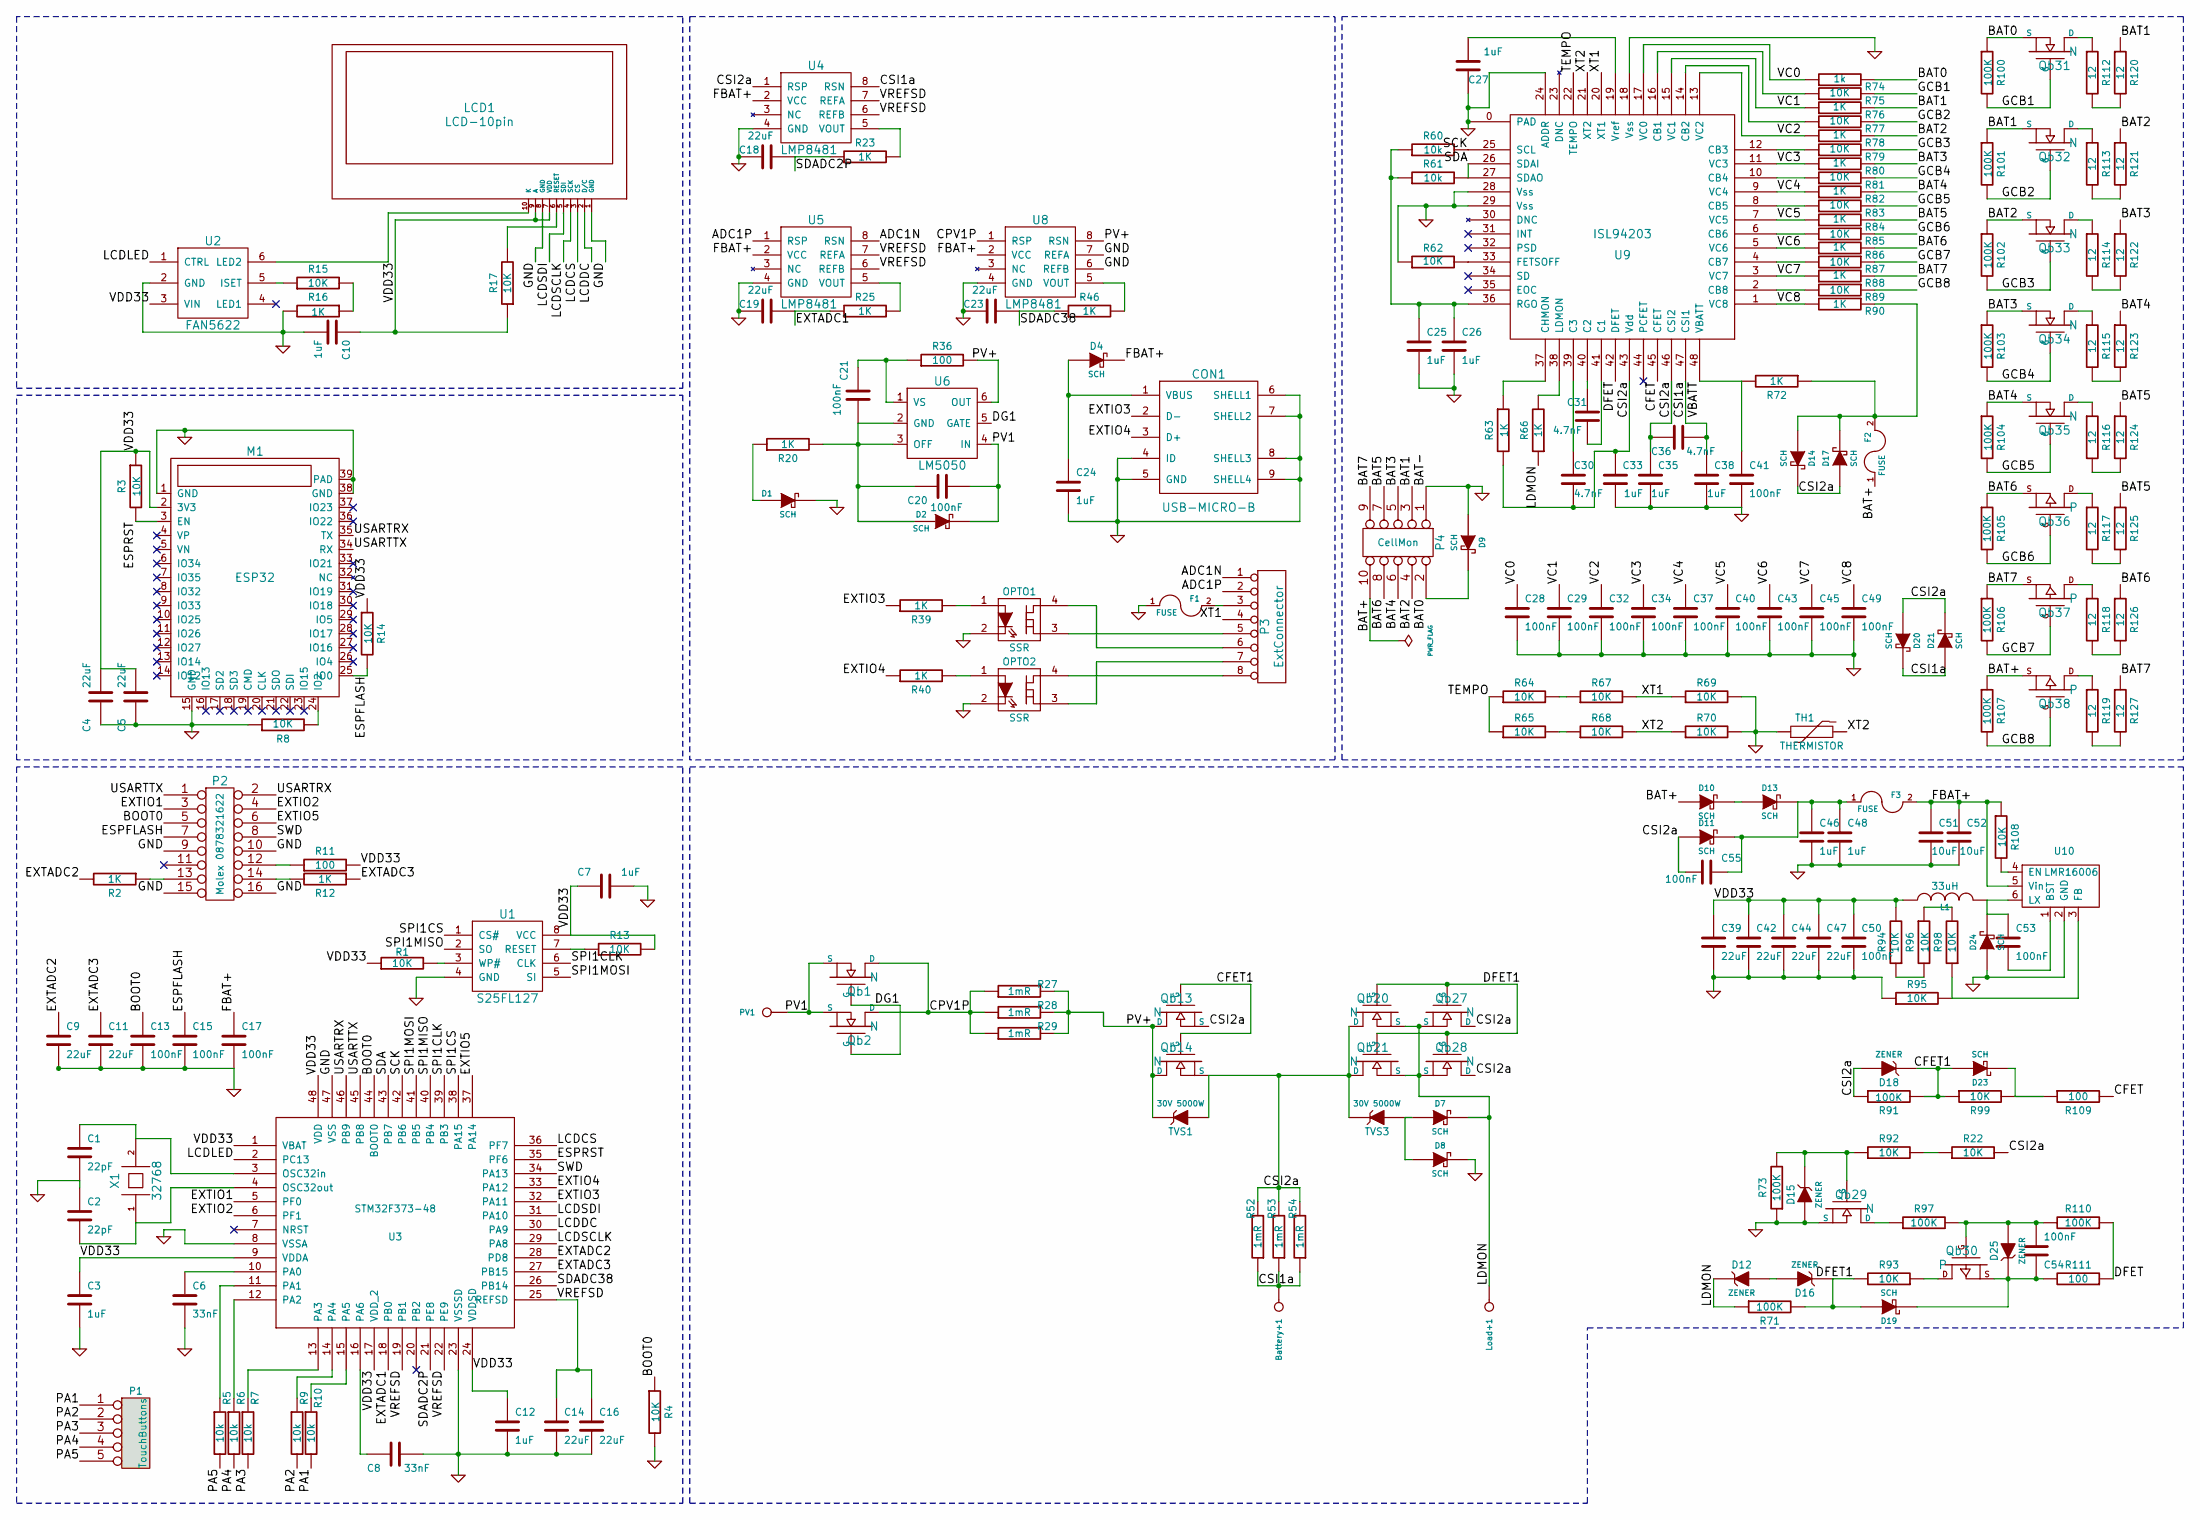
[picture p120: schematic BMS-dacus.sch, 8 Cell Programmable BMS / solar charger SBMS40]

Parts:
Battery+1: CONN_1; 1PIN_Power-dac-65A2
C1, C2: 22pF; SM0603_Capa
C3, C7, C10, C12, C24, C25, C26, C27, C33, C35, C38, C46, C48: 1uF; SM0805-dac
C4, C5, C9, C11, C14, C16, C18, C19, C23, C39, C42, C44, C47: 22uF; SM0805-dac
C6, C8: 33nF; SM0805-dac
C13, C15, C17, C20, C21, C28, C29, C32, C34, C37, C40, C41, C43, C45, C49, C50, C53, C54, C55: 100nF; SM0805-dac
C30, C31, C36: 4.7nF; SM0805-dac
C51, C52: 10uF; SM1206
CON1: USB-MICRO-B; USB_MICRO_B-2
D1, D2, D4, D10, D11, D13, D14, D17, D19, D20, D21, D23, D24: SCH; Diode-dac3
D7: SCH; SBRT20M80-dac-simple4-D7
D8: SCH; SBRT20M80-dac-simple4-D8
D9: SCH; SBRT20M80-dac-simple4-D9
D12, D15, D16, D18, D25: ZENER; Diode-dac3
F1, F2, F3: FUSE; SM1808-dac
L1: 33uH; 5x5-L1
LCD1: LCD-10pin; LCD-24-10pin
Load+1: CONN_1; 1PIN_Power-dac-65A2
M1: ESP32; ESP32-2
OPTO1, OPTO2: SSR; Opto-dac3
P1: TouchButtons; SIL-5-dac
P2: Molex 0878321622; con_8x2x2mm-dac
P3: ExtConnector; SMD-8-dac1
P4: CellMon; 5x2_SMD-dac
PV1: CONN_1; 1PIN_Power-dac-65A2
Qb1, Qb2, Qb13, Qb14, Qb20, Qb21, Qb27, Qb28: N; PG-TDSON-dac-vias3
Qb29, Qb31, Qb32, Qb33, Qb34, Qb35: N; SOT23-dac-4
Qb30, Qb36, Qb37, Qb38: P; SOT23-dac-4
R1, R3, R4, R8, R13, R14, R15, R17, R22, R62, R64, R65, R67, R68, R69, R70, R75, R77, R79, R81, R83, R85, R87, R89, R92, R93, R94, R95, R96, R98, R99, R108: 10K; SM0805-dac
R2, R12, R16, R20, R23, R25, R39, R40, R46, R63, R66, R72, R76, R78, R80, R82, R84, R86, R88, R90: 1K; SM0805-dac
R5, R6, R7, R9, R10, R60, R61: 10k; SM0805-dac
R11, R36, R109, R111: 100; SM0805-dac
R27, R28, R29, R52, R53, R54: 1mR; SM1206
R71, R73, R91, R97, R100, R101, R102, R103, R104, R105, R106, R107, R110: 100K; SM0805-dac
R74: 1k; SM0805-dac
R112, R113, R114, R115, R116, R117, R118, R119, R120, R121, R122, R123, R124, R125, R126, R127: 12; SM0805-dac
TH1: THERMISTOR; SM0805-dac
TVS1: 30V 5000W; DO-214AB-dac-simple4-TVS1
TVS3: 30V 5000W; DO-214AB-dac-simple4-TVS3
U1: S25FL127; Flash-SO8E-dac2
U2: FAN5622; LM5050-SOT23_6-dac
U3: STM32F373-48; LQFP48-3-dac
U4, U5, U8: LMP8481; LMP8481-SSOP8-dac
U6: LM5050; LM5050-SOT23_6-dac
U9: ISL94203; QFP48-dac-3
U10: LMR16006; LM5050-SOT23_6-dac
X1: 32768; 32khz

Connections:
/ADC1N: P3.1, U5.8 (RSN)
/ADC1P: P3.2, U5.1 (RSP)
/BAT0: D9.2 (K), P4.2, Qb31.S, R74.2, R100.1
/BAT1: P4.3, Qb32.S, R76.2, R101.1, R120.1
/BAT2: P4.4, Qb33.S, R78.2, R102.1, R121.1
/BAT3: P4.5, Qb34.S, R80.2, R103.1, R122.1
/BAT4: P4.6, Qb35.S, R82.2, R104.1, R123.1
/BAT5: P4.7, R84.2, R124.1, R125.1
/BAT6: P4.8, Qb36.S, R86.2, R105.1, R126.1
/BAT7: P4.9, Qb37.S, R88.2, R106.1, R127.1
/BAT+: D10.1 (A), F2.1, P4.10, Qb38.S, R107.1
/BOOT0: C13.1, P2.5, R4.1, U3.44 (BOOT0)
/CFET: R109.2, U9.45 (CFET)
/CFET1: D18.2 (K), D23.1 (A), Qb13.G, Qb14.G, R91.2, R99.1
/CPV1P: Qb1.D, Qb2.D, R27.1, R28.1, R29.1, U8.1 (RSP)
/CSI1a: Battery+1.1, C36.1, C38.1, D20.2 (K), D21.1 (A), R52.1, R53.1, R54.1, U4.8 (RSN), U9.47 (CSI1)
/CSI2a: C30.2, C33.2, C35.1, C36.2, C55.2, D11.1 (A), D14.2 (K), D17.1 (A), D18.1 (A), D20.1 (A), D21.2 (K), Qb13.S, Qb14.S, Qb20.D, Qb21.D, Qb27.D, Qb28.D, R22.2, R52.2, R53.2, R54.2, R63.2, R91.1, TVS1.1 (A), TVS3.2 (K), U4.1 (RSP), U9.43 (Vdd), U9.46 (CSI2)
/DFET: R110.1, R111.1, U9.42 (DFET)
/DFET1: D16.2 (K), D19.1 (A), Qb20.G, Qb21.G, Qb27.G, Qb28.G, R71.2, R93.2
/DG1: Qb1.G, Qb2.G, U6.5 (GATE)
/ESPFLASH: C15.1, M1.25 (IO0), P2.7, R14.2
/ESPRST: M1.3 (EN), R3.2, U3.35 (PF6)
/EXTADC1: C19.2, R25.1, U3.18 (PB0)
/EXTADC2: C9.1, R2.2, U3.28 (PD8)
/EXTADC3: C11.1, R12.1, U3.27 (PB15)
/EXTIO1: P2.3, U3.5 (PF0)
/EXTIO2: P2.4, U3.6 (PF1)
/EXTIO3: CON1.2 (D-), R39.1, U3.32 (PA11)
/EXTIO4: CON1.3 (D+), R40.1, U3.33 (PA12)
/EXTIO5: P2.6, U3.37 (PA14)
/FBAT+: C17.1, C51.1, C52.1, D4.2 (K), F3.2, R108.1, U4.2 (VCC), U5.2 (VCC), U8.2 (VCC), U10.5 (Vin)
/GCB1: Qb31.G, R75.2, R100.2
/GCB2: Qb32.G, R77.2, R101.2
/GCB3: Qb33.G, R79.2, R102.2
/GCB4: Qb34.G, R81.2, R103.2
/GCB5: Qb35.G, R83.2, R104.2
/GCB6: Qb36.G, R85.1, R105.2
/GCB7: Qb37.G, R87.1, R106.2
/GCB8: Qb38.G, R89.1, R107.2
/LCDCS: LCD1.3 (CS), U3.36 (PF7)
/LCDDC: LCD1.2 (D/C), U3.30 (PA9)
/LCDLED: U2.1 (CTRL), U3.2 (PC13)
/LCDSCLK: LCD1.4 (SCK), U3.29 (PA8)
/LCDSDI: LCD1.5 (SDI), U3.31 (PA10)
/LDMON: D7.2 (K), D12.2 (K), Load+1.1, Qb20.S, Qb21.S, Qb27.S, Qb28.S, R66.1, R71.1
/PA1: P1.1, R10.2
/PA2: P1.2, R9.2
/PA3: P1.3, R7.2
/PA4: P1.4, R6.2
/PA5: P1.5, R5.2
/PV1: C20.2, D2.2 (K), PV1.1, Qb1.S, Qb2.S, U6.4 (IN)
/PV+: Qb13.D, Qb14.D, R27.2, R28.2, R29.2, R36.2, TVS1.2 (K), U6.6 (OUT), U8.8 (RSN)
/SCK: R60.2, U3.42 (PB6), U9.25 (SCL)
/SDA: R61.2, U3.43 (PB7), U9.26 (SDAI), U9.27 (SDAO)
/SDADC2P: C18.2, R23.1, U3.21 (PE8)
/SDADC38: C23.2, R46.1, U3.26 (PB14)
/SPI1CLK: U1.6 (CLK), U3.39 (PB3)
/SPI1CS: U1.1 (CS#), U3.38 (PA15)
/SPI1MISO: U1.2 (SO), U3.40 (PB4)
/SPI1MOSI: U1.5 (SI), U3.41 (PB5)
/SWD: P2.8, U3.34 (PA13)
/TEMPO: R64.1, R65.1, U9.22 (TEMPO)
/USARTRX: M1.35 (TX), P2.2, U3.46 (PB9)
/USARTTX: M1.34 (RX), P2.1, U3.45 (PB8)
/VBATT: C41.1, R72.2, U9.48 (VBATT)
/VC0: C28.1, R74.1, U9.17 (VC0)
/VC1: C29.1, R76.1, U9.15 (VC1)
/VC2: C32.1, R78.1, U9.13 (VC2)
/VC3: C34.1, R80.1, U9.11 (VC3)
/VC4: C37.1, R82.1, U9.9 (VC4)
/VC5: C40.1, R84.1, U9.7 (VC5)
/VC6: C43.1, R86.1, U9.5 (VC6)
/VC7: C45.1, R88.1, U9.3 (VC7)
/VC8: C49.1, R90.2, U9.1 (VC8)
/VDD33: C3.1, C4.2, C5.2, C7.1, C10.1, C12.1, C39.1, C42.1, C44.1, C47.1, C50.1, L1.1, LCD1.7 (VDD), LCD1.9 (A), M1.2 (3V3), R1.1, R3.1, R11.2, R13.2, R14.1, R17.1, R94.2, U1.8 (VCC), U2.3 (VIN), U3.1 (VBAT), U3.9 (VDDA), U3.17 (VDD_2), U3.24 (VDDSD), U3.48 (VDD)
/VREFSD: C14.1, C16.1, U3.19 (PB1), U3.22 (PE9), U3.25 (REFSD), U4.6 (REFB), U4.7 (REFA), U5.6 (REFB), U5.7 (REFA)
/XT1: P3.4, R67.2, R69.1, U9.20 (XT1)
/XT2: R68.2, R70.1, TH1.2, U9.21 (XT2)
GND: C1.2, C2.1, C3.2, C4.1, C5.1, C6.2, C7.2, C8.2, C9.2, C10.2, C11.2, C12.2, C13.2, C14.2, C15.2, C16.2, C17.2, C18.1, C19.1, C23.1, C24.2, C25.2, C26.2, C27.1, C28.2, C29.2, C32.2, C33.1, C34.2, C35.2, C37.2, C38.2, C39.2, C40.2, C41.2, C42.2, C43.2, C44.2, C45.2, C46.2, C47.2, C48.2, C49.2, C50.2, C51.2, C52.2, CON1.4 (ID), CON1.5 (GND), CON1.6 (SHELL1), CON1.7 (SHELL2), CON1.8 (SHELL3), CON1.9 (SHELL4), D1.2 (K), D8.2 (K), D9.1 (A), D15.1 (A), D24.1 (A), F1.1, LCD1.1 (GND), LCD1.8 (GND), M1.1 (GND), M1.15 (GND), M1.38 (GND), M1.39 (PAD), OPTO1.2, OPTO2.2, P2.9, P2.10, P2.15, P2.16, P4.1, Qb29.S, R4.2, R8.1, R16.2, R62.1, R69.2, R70.2, R73.1, R95.1, TH1.1, U1.4 (GND), U2.2 (GND), U3.8 (VSSA), U3.23 (VSSSD), U3.47 (VSS), U4.4 (GND), U5.4 (GND), U8.4 (GND), U8.6 (REFB), U8.7 (REFA), U9.0 (PAD), U9.18 (Vss), U9.24 (ADDR), U9.28 (Vss), U9.29 (Vss), U10.2 (GND)
unnamed: C1.1, U3.3 (OSC32in), X1.2
unnamed: C2.2, U3.4 (OSC32out), X1.1
unnamed: C6.1, U3.10 (PA0)
unnamed: C8.1, U3.16 (PA6)
unnamed: C20.1, C21.2, D2.1 (A), R20.2, U6.2 (GND), U6.3 (OFF)
unnamed: C21.1, R36.1, U6.1 (VS)
unnamed: C24.1, CON1.1 (VBUS), D4.1 (A)
unnamed: C25.1, C26.1, R60.1, R61.1, U9.36 (RGO)
unnamed: C27.2, U9.19 (Vref)
unnamed: C30.1, U9.39 (C3)
unnamed: C31.1, U9.40 (C2)
unnamed: C31.2, U9.41 (C1)
unnamed: C46.1, C48.1, C55.1, D11.2 (K), D13.2 (K), F3.1
unnamed: C53.1, D24.2 (K), L1.2, U10.6 (LX)
unnamed: C53.2, U10.1 (BST)
unnamed: C54.1, D19.2 (K), D25.2 (K), Qb30.S, R111.2
unnamed: C54.2, D25.1 (A), Qb30.G, R97.2, R110.2
unnamed: D1.1 (A), R20.1
unnamed: D7.1 (A), D8.1 (A), TVS3.1 (A)
unnamed: D10.2 (K), D13.1 (A)
unnamed: D12.1 (A), D16.1 (A)
unnamed: D14.1 (A), D17.2 (K), F2.2, R72.1, R90.1
unnamed: D15.2 (K), Qb29.G, R73.2, R92.1
unnamed: D23.2 (K), R99.2, R109.1
unnamed: F1.2, P3.3
unnamed: LCD1.6 (RESET), R17.2
unnamed: LCD1.10 (K), U2.6 (LED2)
unnamed: M1.24 (IO2), R8.2
unnamed: OPTO1.1, R39.2
unnamed: OPTO1.3, P3.5
unnamed: OPTO1.4, P3.6
unnamed: OPTO2.1, R40.2
unnamed: OPTO2.3, P3.7
unnamed: OPTO2.4, P3.8
unnamed: P2.12, R11.1
unnamed: P2.13, R2.1
unnamed: P2.14, R12.2
unnamed: Qb29.D, R97.1
unnamed: Qb30.D, R93.1
unnamed: Qb31.D, R112.1
unnamed: Qb32.D, R113.1
unnamed: Qb33.D, R114.1
unnamed: Qb34.D, R115.1
unnamed: Qb35.D, R116.1
unnamed: Qb36.D, R117.1
unnamed: Qb37.D, R118.1
unnamed: Qb38.D, R119.1
unnamed: R1.2, U1.3 (WP#)
unnamed: R5.1, U3.11 (PA1)
unnamed: R6.1, U3.12 (PA2)
unnamed: R7.1, U3.13 (PA3)
unnamed: R9.1, U3.14 (PA4)
unnamed: R10.1, U3.15 (PA5)
unnamed: R13.1, U1.7 (RESET)
unnamed: R15.1, U2.5 (ISET)
unnamed: R15.2, R16.1
unnamed: R22.1, R92.2
unnamed: R23.2, U4.5 (VOUT)
unnamed: R25.2, U5.5 (VOUT)
unnamed: R46.2, U8.5 (VOUT)
unnamed: R62.2, U9.33 (FETSOFF)
unnamed: R63.1, U9.37 (CHMON)
unnamed: R64.2, R67.1
unnamed: R65.2, R68.1
unnamed: R66.2, U9.38 (LDMON)
unnamed: R75.1, U9.16 (CB1)
unnamed: R77.1, U9.14 (CB2)
unnamed: R79.1, U9.12 (CB3)
unnamed: R81.1, U9.10 (CB4)
unnamed: R83.1, U9.8 (CB5)
unnamed: R85.2, U9.6 (CB6)
unnamed: R87.2, U9.4 (CB7)
unnamed: R89.2, U9.2 (CB8)
unnamed: R94.1, R96.2
unnamed: R95.2, R98.1, U10.3 (FB)
unnamed: R96.1, R98.2
unnamed: R108.2, U10.4 (EN)
unnamed: R112.2, R120.2
unnamed: R113.2, R121.2
unnamed: R114.2, R122.2
unnamed: R115.2, R123.2
unnamed: R116.2, R124.2
unnamed: R117.2, R125.2
unnamed: R118.2, R126.2
unnamed: R119.2, R127.2

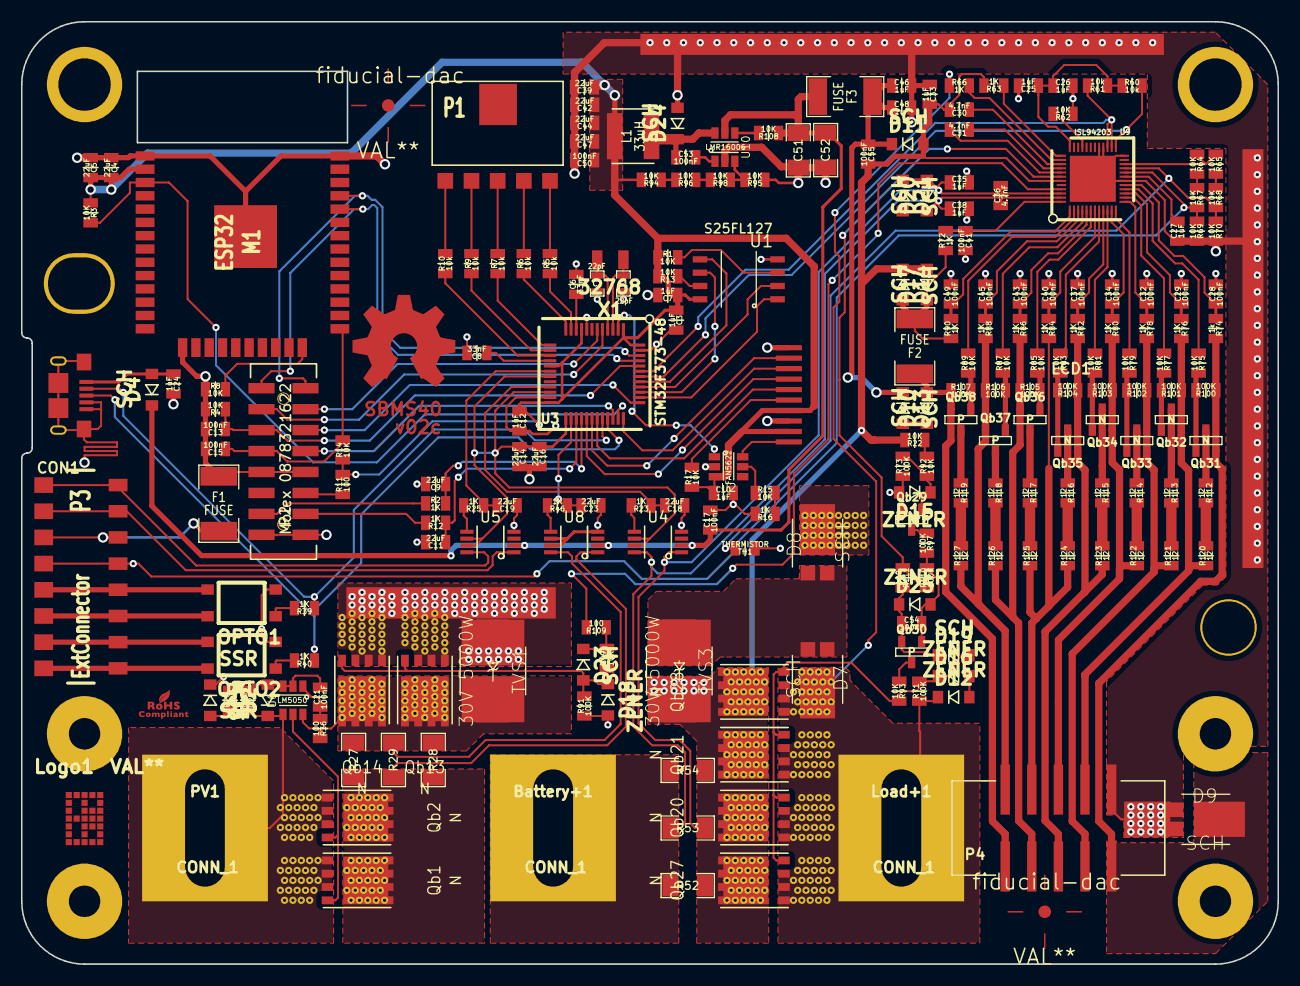
[picture p121: board playground/SBMS_HW/SBMS40_v02c/main-pcb-40/BMS-dacus.kicad_pcb from above]

Board: 2 copper layers, 120.0 x 90.0 mm, 225 parts (0 on the bottom side), 164 nets.

Other parts of the board:
Logo1: VAL**; Logo1
OSHW_COPPER_10MM: VAL**; OSHW_COPPER_10MM
fiducial-dac: VAL**; fiducial-dac3
fiducial-dac#2: VAL**; fiducial-dac3
