kitspace/component_tester/playground/SBMS_HW/SBMS120_v03d/front-pcb-120/BMS-dacus.kicad_pcb

## KiCad design playground/SBMS_HW/SBMS120_v03d/front-pcb-120/BMS-dacus.kicad_pcb (2020-09-11)

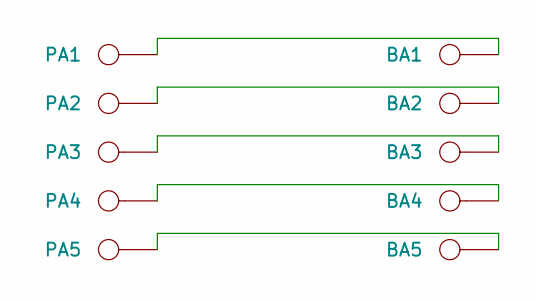
[picture p122: schematic BMS-dacus.sch, 8 Cell Programmable BMS / solar charger SBMS120]

Parts:
BA1, BA2, BA3, BA4, BA5: CONN_1; button_SMD-dac4
PA1, PA2, PA3, PA4, PA5: CONN_1; button_contact_SMD-dac3

Connections:
unnamed: BA1.1, PA1.1
unnamed: BA2.1, PA2.1
unnamed: BA3.1, PA3.1
unnamed: BA4.1, PA4.1
unnamed: BA5.1, PA5.1

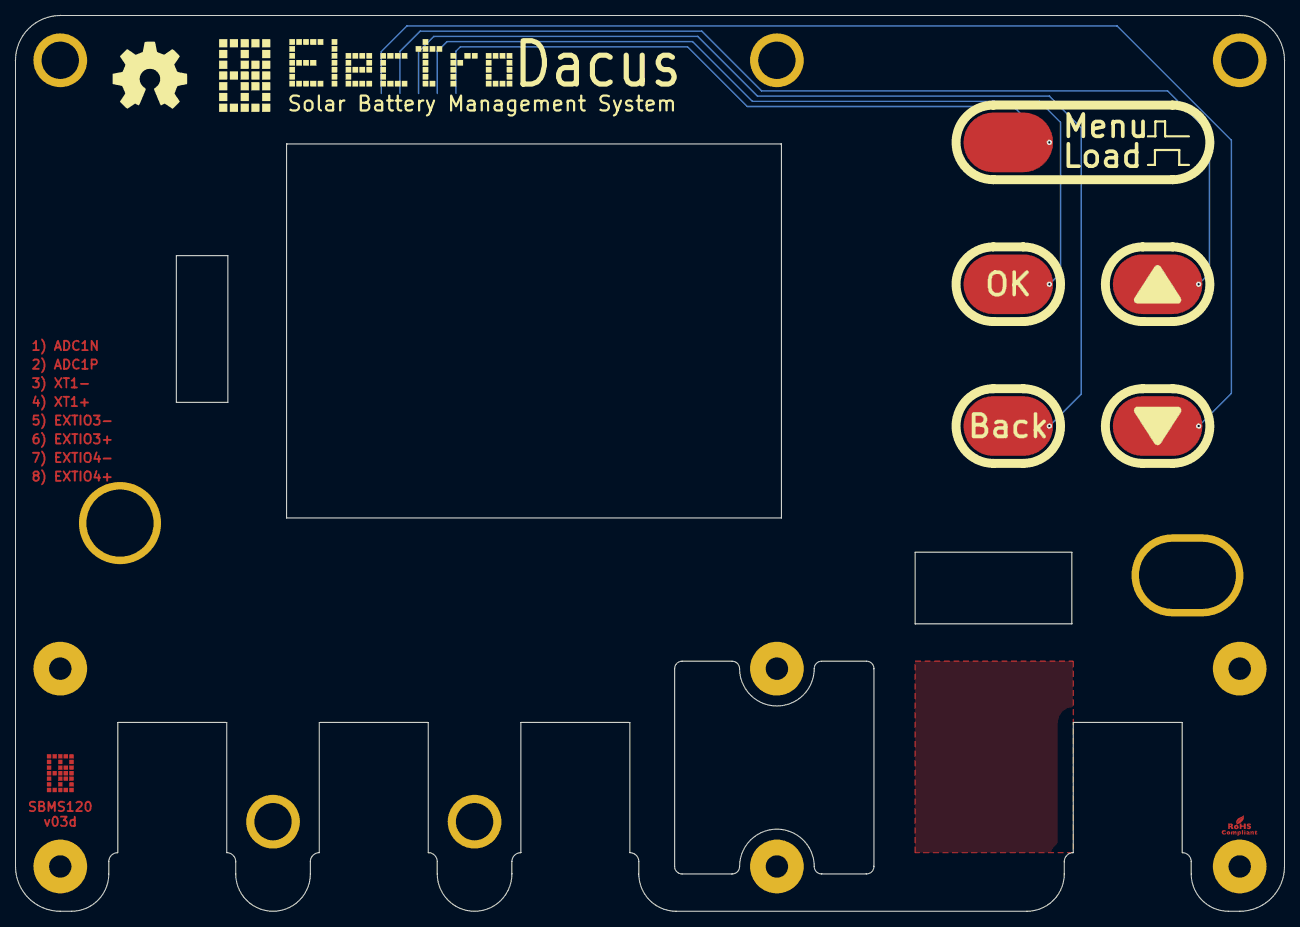
[picture p123: board playground/SBMS_HW/SBMS120_v03d/front-pcb-120/BMS-dacus.kicad_pcb from above]

Board: 2 copper layers, 170.0 x 120.0 mm, 11 parts (0 on the bottom side), 5 nets.

Other parts of the board:
Logo1: VAL**; Logo1
