kitspace/component_tester/playground/SBMS_HW/SBMS40_v02c/back-pcb-40/BMS-dacus.kicad_pcb

## KiCad design playground/SBMS_HW/SBMS40_v02c/back-pcb-40/BMS-dacus.kicad_pcb (2020-09-11)

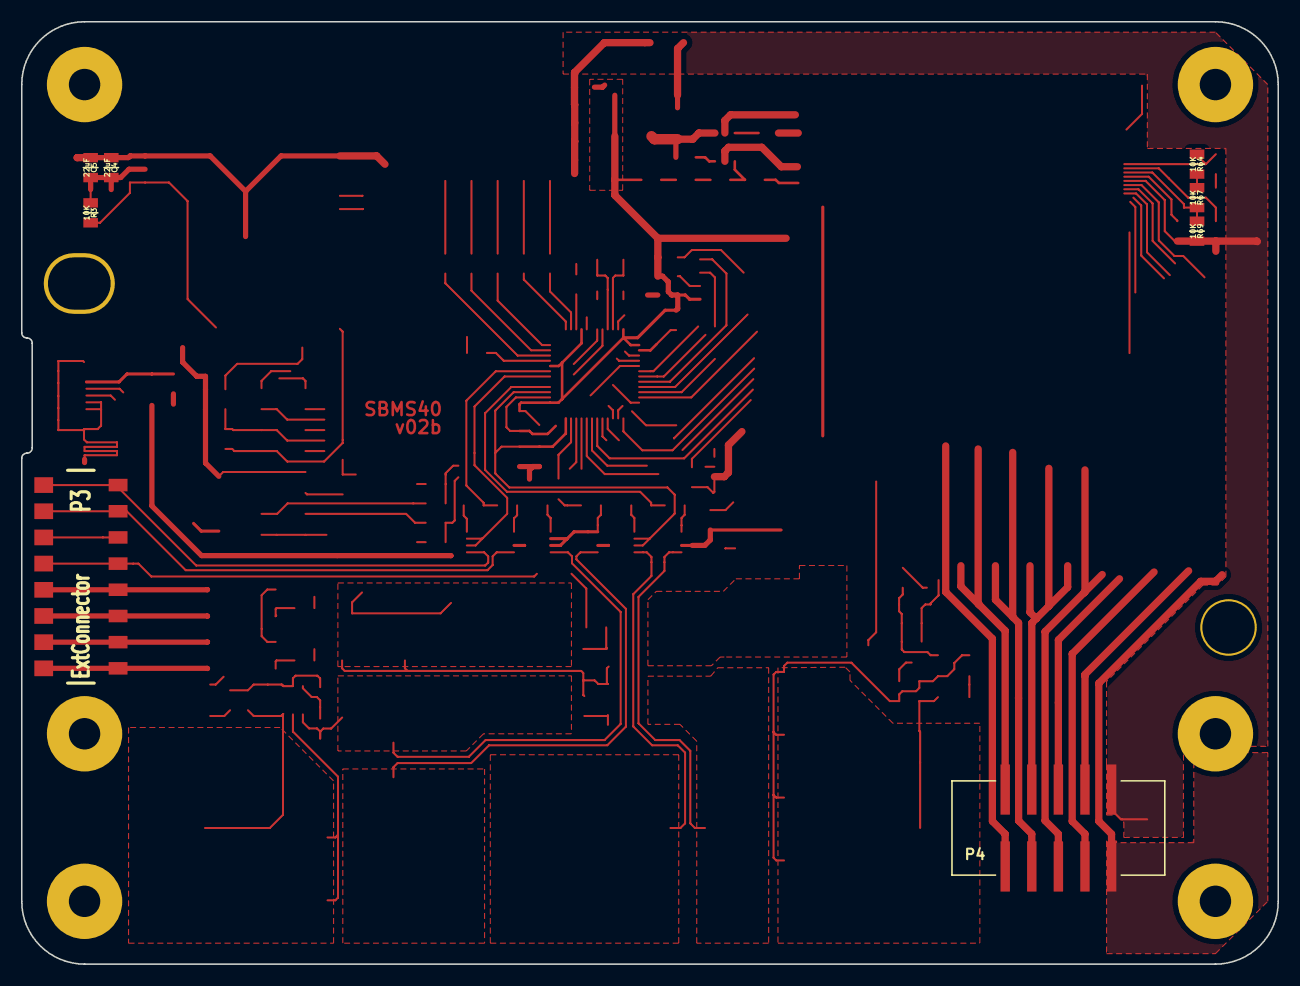
[picture p124: board playground/SBMS_HW/SBMS40_v02c/back-pcb-40/BMS-dacus.kicad_pcb from above]

Board: 2 copper layers, 120.0 x 90.0 mm, 9 parts (1 on the bottom side), 4 nets.

Parts:
C4, C5: 22uF; SM0805-dac
Logo1: VAL**; Logo1
P3: ExtConnector; SMD-8-dac1
P4: CellMon; 5x2_SMD-dac
R3, R64, R67, R69: 10K; SM0805-dac

Connections:
/VDD33: C4.2, C5.2, R3.1
/XT1: P3.4, R67.2, R69.1
GND: C4.1, C5.1, P4.1, R69.2
unnamed: R64.2, R67.1
