kitspace/component_tester/kicad/component_tester.kicad_pcb

## KiCad design kicad/component_tester.kicad_pcb (2018-10-08)

Schematic: component_tester.sch

Parts:
DRAWING101: DRAWING; combined

Schematic: component_tester_1.sch

Parts:
BAT201: CR2032; Battery_Retainer_2032_BK-912
C201: 10uF; C_0805
C202: 100n; C_0402
C203, C207: 47u; C_0805
C204, C205: 22p; C_0201
C206: 1n; C_0201
C208, C209, C210, C211, C212, C213: V 3p; C_0201
D201: BAV99; SOT-523; MPN1 BAV99T-7-F
D203: BAS40; LED_0402; MPN BAS40LP-7
DRAWING201: DRAWING; pads
DRAWING202: DRAWING; pads_bottom
IC201: MCP1640; SOT23-6
IC202: ATmega328P-MMH; QFN-28-1EP_4x4mm_Pitch0.4mm
L201: 4.7uH; R_0603
Q201: 8 MHz; NDK-NX3225GA_xtal
R201, R202, R203, R205, R210, R211, R212, R213: 10k; R_0201
R204: 1M; R_0201
R206: 750k; R_0201
R207: 240k; R_0201
R209: 330k; R_0201
R214, R216, R218: 680; R_0201
R215, R217, R219: 470k; R_0201
SW201: EVQ; PANASONIC_EVQ
T201: PMV65XP; SOT23
T202: BSS84; SOT23
T203: BSS123; SOT-323_SC-70; MPN BSS123W-7-F
T204: BC847; SOT-523; MPN BC847AT-7-F
X201: MICRO-USB; TE_1981568-1
X202: ISP; Pin_Header_Straight_2x03_Pitch1.27mm

Connections:
+5V: C201.1, C202.2, C207.1, IC201.5, IC202.3 (VCC), IC202.16 (AVCC), R202.2, R206.2, R211.2, X202.2; also elsewhere on the board
+BATT: BAT201.1, T201.3; also elsewhere on the board
/component_tester_1/~RESET: IC202.25 (~RESET~/PC6), R202.1, X202.5
GND: BAT201.2, C201.2, C202.1, C203.2, C204.1, C205.1, C206.1, C207.2, C208.2, C209.2, C210.2, C211.2, C212.2, C213.2, IC201.2, IC202.4 (GND), IC202.18 (GND), IC202.29 (GND), R201.1, R203.1, R207.2, R209.1, R210.2, R212.1, T203.2, T204.2, X201.5, X202.6; also elsewhere on the board
unnamed: C203.1, D201.2, IC201.6, L201.1, R204.2, R205.2, SW201.1, SW201.2, T201.2, T202.2
unnamed: C204.2, IC202.6 (XTAL2/PB7), Q201.2
unnamed: C205.2, IC202.5 (XTAL1/PB6), Q201.1
unnamed: C206.2, IC202.17 (AREF)
unnamed: C208.1, C211.1, DRAWING201.1, DRAWING202.1, IC202.19 (PC0), R214.2, R215.2
unnamed: C209.1, C212.1, DRAWING201.2, DRAWING202.2, IC202.20 (PC1), R216.2, R217.2
unnamed: C210.1, C213.1, DRAWING201.3, DRAWING202.3, IC202.21 (PC2), R218.2, R219.2
unnamed: D203.1, R210.1, SW201.3, SW201.4, T203.1
unnamed: IC202.8 (PD6), R212.2, R213.2
unnamed: IC201.1, L201.2
unnamed: IC201.3, R203.2, T202.3
unnamed: IC201.4, R206.1, R207.1
unnamed: IC202.9 (PD7), R211.1, T203.3
unnamed: IC202.10 (PB0), R214.1
unnamed: IC202.11 (PB1), R215.1
unnamed: IC202.12 (PB2), R216.1
unnamed: IC202.13 (PB3), R217.1, X202.4
unnamed: IC202.14 (PB4), R218.1, X202.1
unnamed: IC202.15 (PB5), R219.1, X202.3
unnamed: IC202.24 (PC5), R204.1, R209.2
unnamed: R205.1, T202.1, T204.3
unnamed: R213.1, T204.1
SEROUT: IC202.22 (PC3); also elsewhere on the board
SUP_UART: D201.3; also elsewhere on the board
USBDM: X201.2; also elsewhere on the board
USBDP: X201.3; also elsewhere on the board
VCC: D201.1, R201.2, T201.1, X201.1; also elsewhere on the board

Notes on the sheet:
Knopfzelle
CR2032
Supply-Netze:
+5V = Spannungsregler-Ausgang
VCC = 5V vom USB
VI = Spannungsregler-Eingang
+BATT = 3V von Lithiumzelle
K.-H. Kübbeler, DF3DCB, DH8GHH

Schematic: component_tester_2.sch

Parts:
C301: 100n; C_0805
C302, C303: 4,7u; C-TAN_A
IC301: FT232RL; SSOP28
IC302: MAX1811; SO08
J301, J302: 0R-JUMPA; A0R-JMP
LED301: LEDCHIP-LED0805; CHIP-LED0805
R301: 100; R_0402
T301: BSS123; SOT23

Connections:
+BATT: C302.+, IC302.5; also elsewhere on the board
GND: C301.1, C302.-, C303.-, IC301.7, IC301.18, IC301.21, IC301.25, IC301.26, IC302.2, IC302.3, IC302.6, J302.3; also elsewhere on the board
unnamed: IC301.5, T301.2
unnamed: IC302.7, J302.2
unnamed: IC302.8, LED301.C
unnamed: LED301.A, R301.2
SEROUT: T301.3; also elsewhere on the board
SUP_UART: C301.2, IC301.4, IC301.20; also elsewhere on the board
USBDM: IC301.16; also elsewhere on the board
USBDP: IC301.15; also elsewhere on the board
VCC: C303.+, IC302.4, J301.2, J302.1, R301.1, T301.1; also elsewhere on the board

Notes on the sheet:
Option USB-Ausgabe
Option Li+ Charger

Schematic: component_tester_3.sch

Parts:
C403: 10uF; C_0805
C404, C406, C407, C408: 1uF; C_0603
C405: 2.2uF/16V; C_0603
D401, D402, D403: 1N4148; SOD-323
OLED1: Conn_01x30; SSD1306
Q401, Q402: BSS138; SOT23-WIDE
R401, R402, R403, R404, R405, R406, R407, R408: 10K; R_0201
R409: 390K; R_0201

Connections:
+5V: R403.2, R404.2; also elsewhere on the board
+BATT: C407.2, C408.2, OLED1.6, OLED1.9, Q401.1, Q402.1, R401.2, R402.2, R405.2, R406.2, R407.2; also elsewhere on the board
/component_tester_3/CS_3.3V: D401.A, OLED1.13, R405.1
/component_tester_3/CS_5.0V: D401.C
/component_tester_3/D0/SCLK/SCK_3.3V: OLED1.18, Q402.2, R402.1
/component_tester_3/D0/SCLK/SCK_5.0V: Q402.3, R404.1
/component_tester_3/D1/MOSI/SDA1_3.3V: OLED1.19, Q401.2, R401.1
/component_tester_3/D1/MOSI/SDA_5.0V: Q401.3, R403.1
/component_tester_3/DC/SA0_3.3V: D403.A, OLED1.15, R407.1
/component_tester_3/DC/SA0_5.0V: D403.C
/component_tester_3/RST_3.3V: D402.A, OLED1.14, R406.1
/component_tester_3/RST_5.0V: D402.C
GND: C403.1, C405.1, C407.1, C408.1, OLED1.1, OLED1.8, OLED1.10, OLED1.12, OLED1.29, OLED1.30, R408.1, R409.1; also elsewhere on the board
unnamed: C403.2, OLED1.28
unnamed: C404.1, OLED1.5
unnamed: C404.2, OLED1.4
unnamed: C405.2, OLED1.27
unnamed: C406.1, OLED1.3
unnamed: C406.2, OLED1.2
unnamed: OLED1.11, R408.2
unnamed: OLED1.26, R409.2

Notes on the sheet:
= 011110+SA0+RW
= 0x7A with DC/SA0_5.0V floating/high
= 0x78 with DC/SA0_5.0V at GND
I2C Address

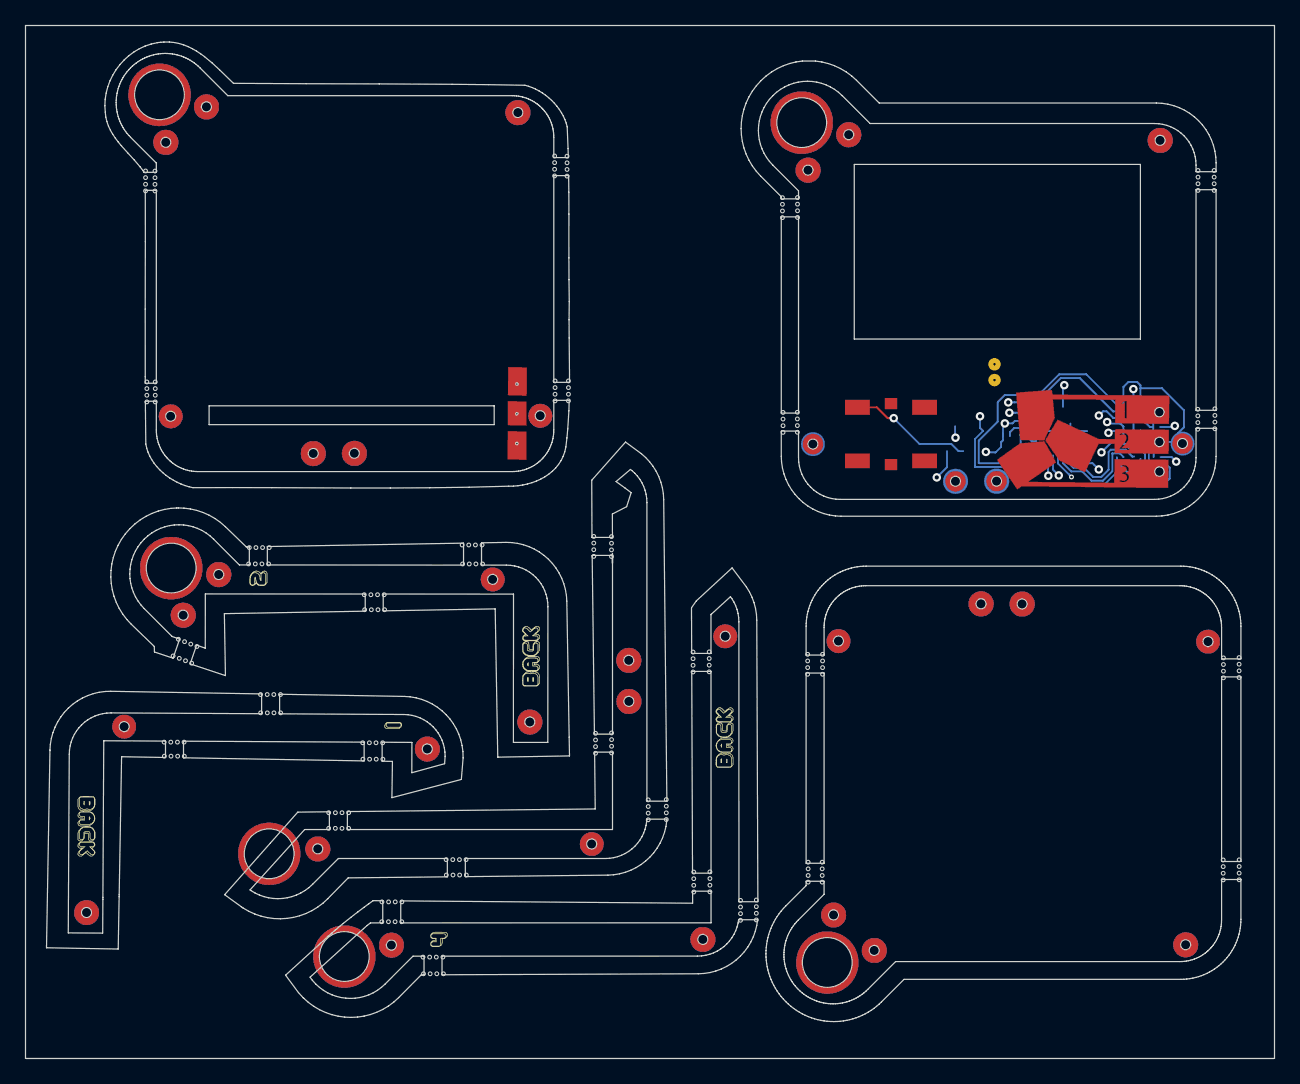
[picture p125: board component_tester.kicad_pcb from above]

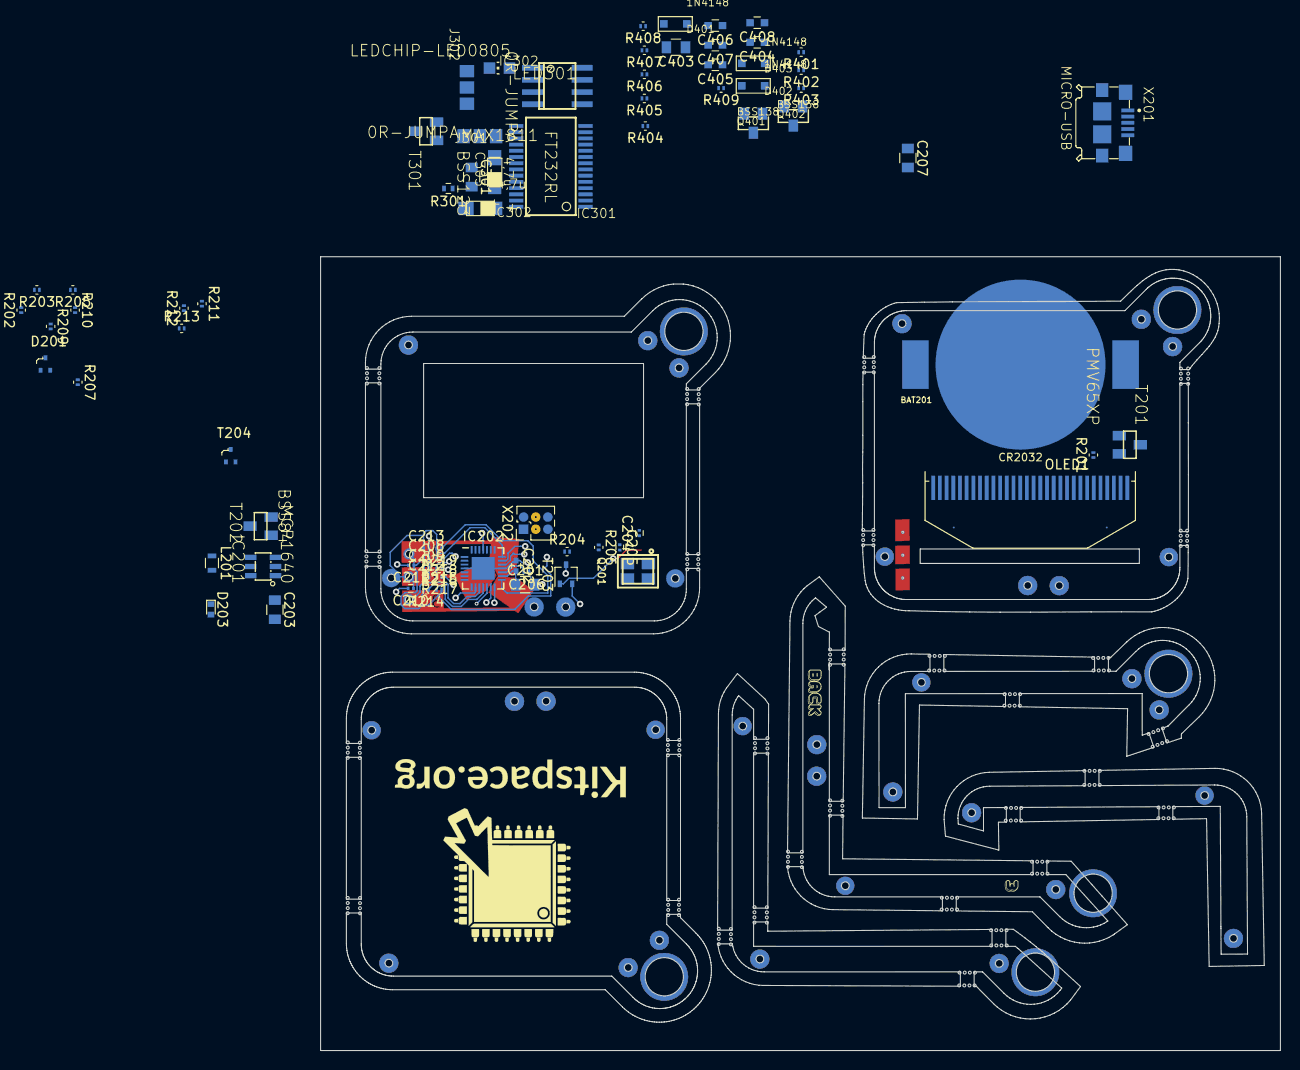
[picture p126: board component_tester.kicad_pcb from below]

Board: 4 copper layers, 100.4 x 83.0 mm, 79 parts (75 on the bottom side), 50 nets.
