kitspace/component_tester/playground/SBMS_HW/SBMS120_v03d/front-pcb-120/old-BMS-dacus.kicad_pcb

## KiCad design playground/SBMS_HW/SBMS120_v03d/front-pcb-120/old-BMS-dacus.kicad_pcb (2020-09-11, an earlier design)

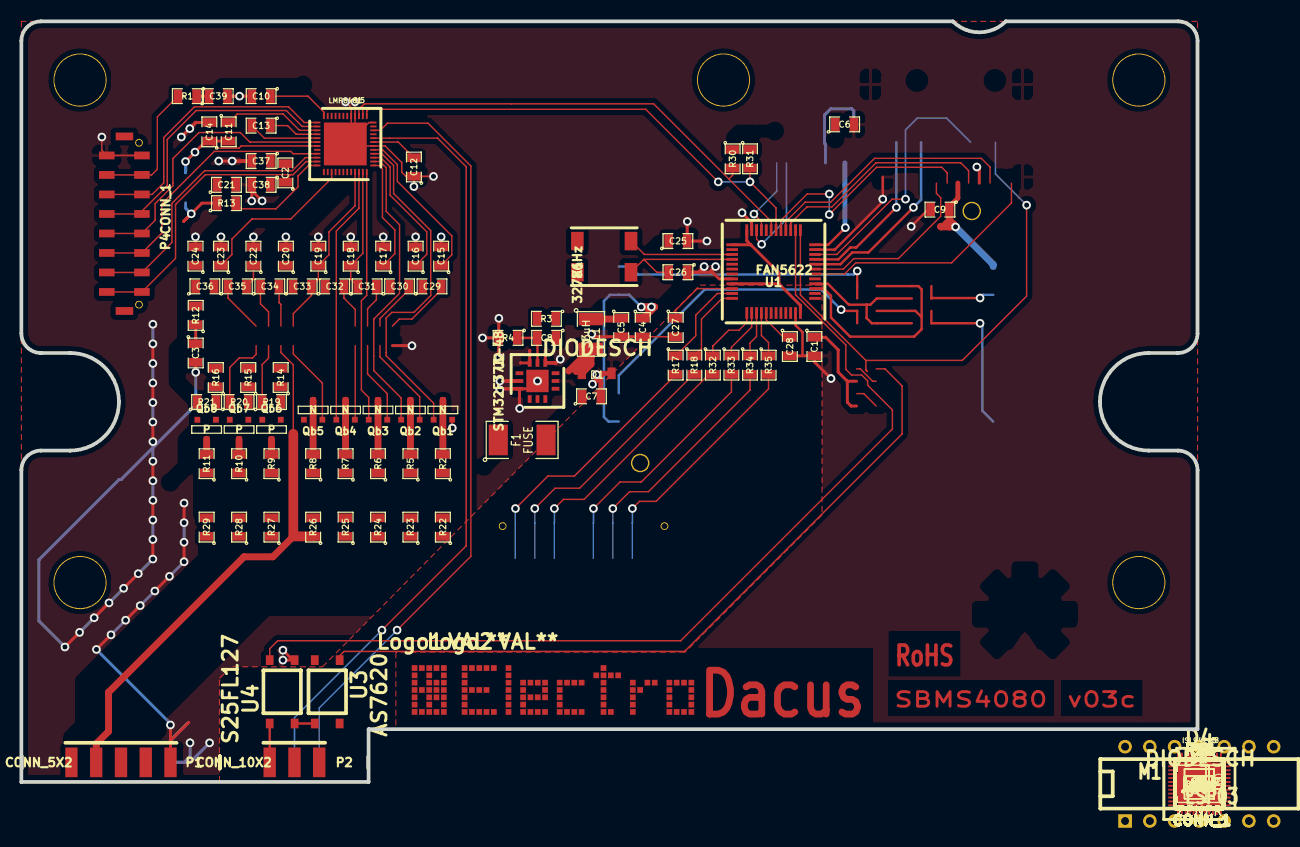
[picture p127: board old-BMS-dacus.kicad_pcb from above]

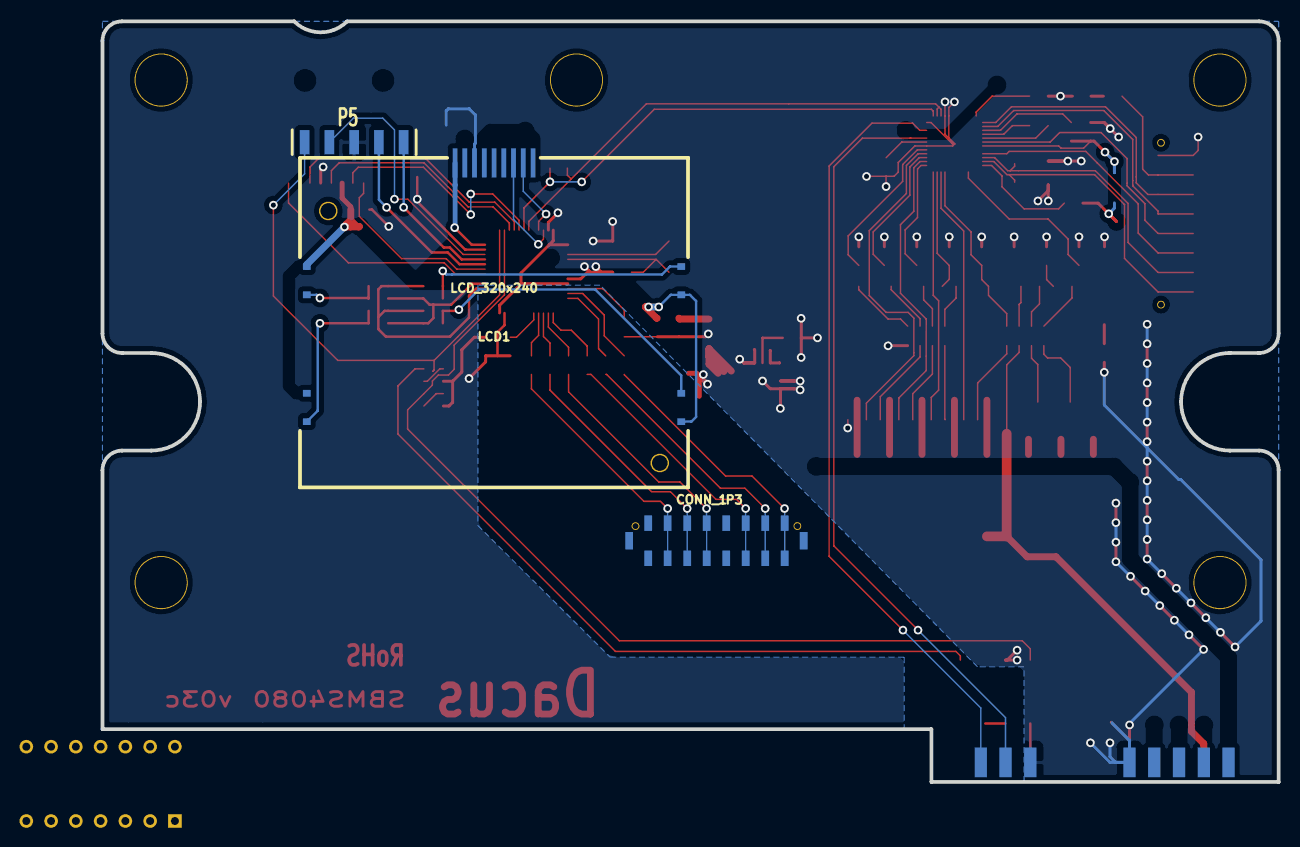
[picture p128: board old-BMS-dacus.kicad_pcb from below]

Board: 2 copper layers, 120.6 x 78.0 mm, 179 parts (3 on the bottom side), 123 nets.

Parts:
C1, C5, C8, C16, C17, C19, C20, C28: 22uF; SM0805
C2, C3: 22pF; SM0805
C4, C6, C9, C18, C21, C24, C27, C30, C32, C35, C37, C38, C39, C40, C41, C42, C43, C44: 100nF; SM0805
C7, C11, C12, C13, C15, C22, C23, C25, C31, C33, C36: 1uF; SM0805
C10, C14: 33nF; SM0805
C26, C29, C34: 4.7nF; SM0805
D1, D4: DIODESCH; Diode1
D2, D3, D5: BAV99U; SOT23_6
D6, D7: ZENER; DO-214AC(SMA)
F1: FUSE; SM1808
L1: 33uH; SM1210
LCD1: LCD_320x240; LCD
Logo1: VAL**; Logo1
Logo2: VAL**; Logo2
M1: ESP03; DIP-14__300
P1: CONN_5X2; 10p-con
P2: CONN_10X2; 6p-con
P3, P4: CONN_1; 60p-power
P5: CONN_1; SMD-5p-dac
P6, P7, P8, P9, P10, P11, P12, P13, P14, P15, P16, P17, P18, P19, P20, P21, P22, P23, P24: CONN_1; 1PIN_SMD
Qb1, Qb2, Qb3, Qb4, Qb5: N; SOT23-dac
Qb6, Qb7, Qb8: P; SOT23-dac
R1, R2, R3, R4, R5, R16, R17: 10k; SM0805
R6, R7, R8, R9, R10, R11, R13, R14, R25, R26, R28, R30, R32, R34, R36, R38, R40, R42, R45, R46, R52, R53: 10K; SM0805
R12, R15, R18, R19, R20, R21, R22, R29, R31, R33, R35, R37, R39, R41, R43, R44, R49: 1K; SM0805
R23, R24, R47, R48, R50, R51: 100; SM0805
R27: 1k; SM0805
R54, R55, R56, R57, R58, R59, R60, R61, R62, R63: 470K; SM0805
R64, R65, R66, R67, R68, R69, R70, R71, R72, R73, R74, R75, R76, R77, R78, R79: 12; SM0805
U1: FAN5622; LQFP48
U2: STM32F373-48; MLPQ12-1
U3: AS7620; Opto
U4: S25FL127; Opto
U5: LMP8481; QFP48-dac-2
U6, U7: LMP8481; SSOP8
U8: ISL94203; QFP48-dac-2
U9, U10: LM5050; SOT23_6
X1: 32786Hz; Quartz

Connections:
/BAT1: P1.3, Qb2.S, R29.2, R57.1, R72.1
/BAT2: P1.4, Qb3.S, R31.2, R58.1, R73.1
/BAT3: P1.5, Qb4.S, R33.2, R59.1, R74.1
/BAT4: P1.6, Qb5.S, R35.2, R60.1, R75.1
/BAT5: P1.7, R37.2, R76.1, R77.1
/BAT6: P1.8, Qb6.S, R39.2, R61.1, R78.1
/BAT7: P1.9, Qb7.S, R41.2, R62.1, R79.1
/BAT+: C4.1, C6.1, C18.1, C26.2, C31.1, D4.1, F1.1, P1.10, Qb8.S, R18.2, R43.1, R44.1, R63.1, U5.2
/BOOT0: P2.2, R8.2
/CFET: R50.1, R51.1, U8.45
/CFET1: D7.2, P15.1, R50.2, R51.2, R55.1
/CPV11: D3.1, D3.2, P19.1, U6.8
/CPV12: D3.6, P20.1, U6.1
/CPV21: D3.3, P21.1, U7.1
/CPV22: D3.4, D3.5, P22.1, U7.8
/CSI1: C34.1, C36.1, P17.1, U8.47
/CSI2: C33.1, C34.2, P16.1, U8.46
/DFET: R47.1, R48.1, U8.42
/DFET1: D6.2, P9.1, R47.2, R48.2, R54.1
/ESPFLASH: M1.7, R10.2
/ESPRST: M1.13, R14.2
/GCB1: Qb1.G, R28.2, R56.2
/GCB2: Qb2.G, R30.2, R57.2
/GCB3: Qb3.G, R32.2, R58.2
/GCB4: Qb4.G, R34.2, R59.2
/GCB5: Qb5.G, R36.2, R60.2
/GCB6: Qb6.G, R38.1, R61.2
/GCB7: Qb7.G, R40.1, R62.2
/GCB8: Qb8.G, R42.1, R63.2
/GPV1: P13.1, U9.5
/GPV2: P14.1, U10.5
/LCDLED: U1.1, U2.2
/LDMON: D6.1, P12.1, R49.2, R54.2
/LDMON1: R49.1, U8.38
/PA1: P3.1, R1.2
/PA2: P4.1, R2.2
/PA3: P5.1, R3.2
/PA4: P6.1, R4.2
/PA5: P7.1, R5.2
/PV1+: C41.2, P10.1, U9.4
/PV2+: C42.2, P11.1, U10.4
/PV+: P8.1, R23.2, R24.2, U6.2, U7.2, U9.6, U10.6
/SCFET: D7.1, P18.1, R55.2
/SCK: R16.1, U8.25
/SDA: R17.1, U8.26, U8.27
/SDADC2P: C19.2, R12.2
/SDADC14: C20.1, R15.1
/SDADC38: C28.2, R20.2
/TEMPO: R25.1, R26.1, U8.22
/USARTRX: M1.11, P2.5
/USARTTX: M1.10, P2.6
/VBATT: C40.1, R44.2, U8.48
/VC0: C21.1, R27.1, U8.17
/VC1: C24.1, R29.1, U8.15
/VC2: C27.1, R31.1, U8.13
/VC3: C30.1, R33.1, U8.11
/VC4: C32.1, R35.1, U8.9
/VC5: C35.1, R37.1, U8.7
/VC6: C39.1, R39.1, U8.5
/VC7: C43.1, R41.1, U8.3
/VC8: C44.1, R43.2, U8.1
/VDD33: C1.1, C5.1, C7.1, C8.1, C9.1, C13.1, C15.1, L1.1, LCD1.9, LCD1.10, M1.1, R9.1, R10.1, R13.1, R14.1, R19.2, U1.3, U2.1, U2.9, U3.5
/VREFSD: C16.1, C17.1, U5.6, U5.7
/XT1: P2.1, R45.2, R52.1, U8.20
/XT2: P24.1, R46.2, R53.1, U8.21
GND: C1.2, C2.2, C3.1, C4.2, C5.2, C6.2, C7.2, C8.2, C9.2, C10.2, C11.2, C12.2, C13.2, C14.2, C15.2, C16.2, C17.2, C18.2, C19.1, C20.2, C21.2, C22.1, C23.2, C24.2, C25.2, C27.2, C28.1, C30.2, C31.2, C32.2, C33.2, C35.2, C36.2, C39.2, C40.2, C43.2, C44.2, D1.1, LCD1.1, LCD1.8, M1.8, P1.1, P1.2, P2.3, P23.1, Qb1.S, R7.2, R8.1, R11.1, R21.2, R22.2, R27.2, R52.2, R53.2, R56.1, U1.2, U2.8, U3.2, U3.4, U4.4, U5.4, U6.4, U6.6, U6.7, U7.4, U7.6, U7.7, U8.0, U8.18, U8.24, U8.28, U8.29
unnamed: M1.5, R11.2
unnamed: R1.1, U2.11
unnamed: R20.1, U7.5
unnamed: D2.4, D2.5, D2.6, U5.8
unnamed: R6.1, U1.5
unnamed: LCD1.2, R9.2
unnamed: D5.2, R21.1
unnamed: D5.3, R22.1
unnamed: R6.2, R7.1
unnamed: R65.2, R73.2
unnamed: Qb2.D, R65.1
unnamed: R64.2, R72.2
unnamed: Qb1.D, R64.1
unnamed: Qb3.D, R66.1
unnamed: C22.2, U8.19
unnamed: Qb8.D, R71.1
unnamed: R18.1, U8.37
unnamed: R71.2, R79.2
unnamed: R70.2, R78.2
unnamed: Qb7.D, R70.1
unnamed: R69.2, R77.2
unnamed: Qb6.D, R69.1
unnamed: R68.2, R76.2
unnamed: Qb5.D, R68.1
unnamed: R67.2, R75.2
unnamed: Qb4.D, R67.1
unnamed: R66.2, R74.2
unnamed: R28.1, U8.16
unnamed: R30.1, U8.14
unnamed: R25.2, R45.1
unnamed: P2.4, R19.1
unnamed: R26.2, R46.1
unnamed: C29.2, U8.41
unnamed: D2.1, D2.2, D2.3, U5.1
unnamed: D4.2, U8.43
unnamed: R12.1, U5.5
unnamed: C37.1, R23.1, U9.1
unnamed: C37.2, C41.1, D5.6, U9.2, U9.3
unnamed: C38.2, C42.1, D5.4, U10.2, U10.3
unnamed: C38.1, R24.1, U10.1
unnamed: R15.2, U6.5
unnamed: C23.1, C25.1, R16.2, R17.2, U8.36
unnamed: LCD1.11, LCD1.12, LCD1.13, LCD1.14, U1.6
unnamed: C26.1, U8.39
unnamed: C2.1, U2.3, X1.1
unnamed: R38.2, U8.6
unnamed: R40.2, U8.4
unnamed: R42.2, U8.2
unnamed: R2.1, U2.12
unnamed: C11.1, C12.1, F1.2, U3.1
unnamed: C3.2, U2.4, X1.3
unnamed: C10.1, U2.10
unnamed: D1.2, L1.2
unnamed: R36.1, U8.8
unnamed: R34.1, U8.10
unnamed: R32.1, U8.12
unnamed: C29.1, U8.40
