kitspace/component_tester/playground/knopf-zelle/Hardware/bauteiltester.brd

## EAGLE design playground/knopf-zelle/Hardware/bauteiltester.brd (2020-09-11)

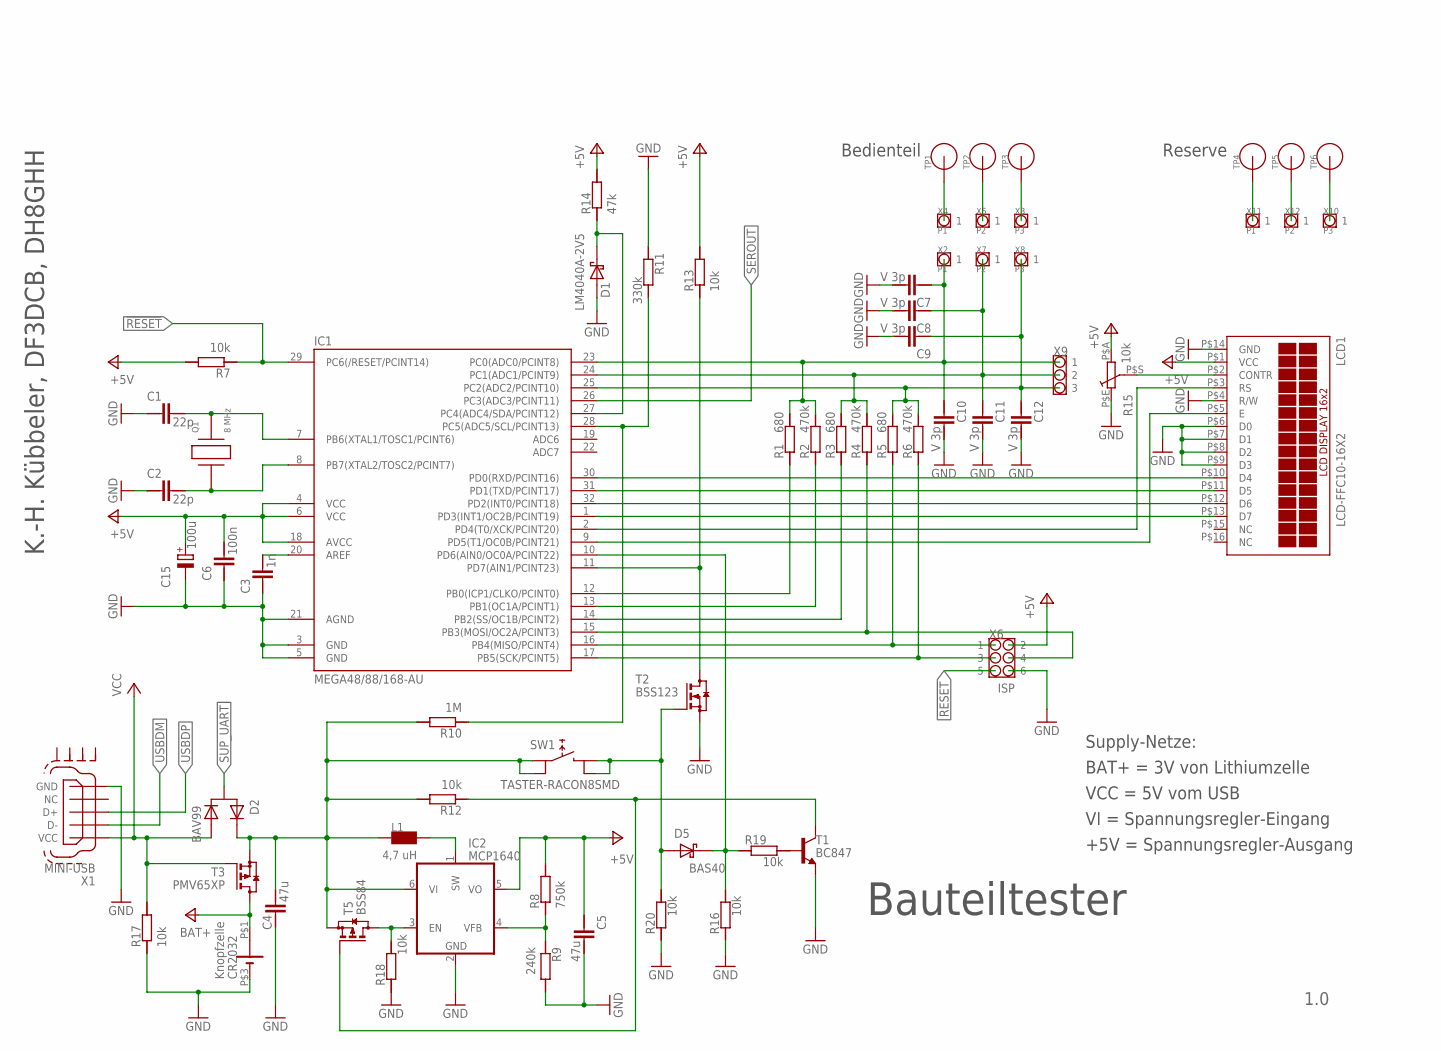
[picture p129: schematic bauteiltester.sch, sheet 1]

Parts:
BAT1: CR2032
C1, C2: 22p; C0805
C3: 1n; C0805
C4, C5: 47u; C0805
C6: 100n; C0805
C7, C8, C9, C10, C11, C12: V 3p; C0603
C15: 100u; D/7343-31W
D1: LM4040A-2V5; SOT23
D2: BAV99; SOT23
D5: BAS40; SOT23
IC1: MEGA48/88/168-AU; TQFP32-08
IC2: MCP1640; SOT23-6
L1: 4,7 uH; L1210
LCD1: LCD-FFC10-16X2; FFC_14P_1MM_TOP
Q1: 8 MHz; HC49UP
R1, R3, R5: 680; R0805
R2, R4, R6: 470k; R0805
R7, R12, R13, R16, R17, R18, R19, R20: 10k; R0805
R8: 750k; R0805
R9: 240k; R0805
R10: 1M; R0805
R11: 330k; R0805
R14: 47k; R0805
R15: 10k; POTI_ACP6-SMD
SW1: TASTER-RACON8SMD
T1: BC847; SOT23
T2: BSS123; SOT23
T3: PMV65XP; SOT23
T5: BSS84; SOT23
TP1, TP2, TP3, TP4, TP5, TP6: SMD-PAD_0.2X0.2; PAD_0.2X0.2
X1: MINI-USB; MINI-USB-B5
X2: P1; STIFT
X3, X10: P3; STIFT_WINKL_SMD
X4, X11: P1; STIFT_WINKL_SMD
X5, X12: P2; STIFT_WINKL_SMD
X6: ISP; WANNE6_PCBKANTE
X7: P2; STIFT
X8: P3; STIFT
X9: STIFTLEISTE_2,54MM_1X3_WI-SMD

Connections:
!RESET: IC1.29 (PC6(/RESET/PCINT14)), R7.1, X6.P$5 (5)
+5V: C5.1, C6.2, C15.+, IC1.4 (VCC), IC1.6 (VCC), IC1.18 (AVCC), IC2.5 (VO), LCD1.P$1 (VCC), R7.2, R8.2, R13.2, R14.2, R15.P$A (A), X6.P$2 (2)
BAT+: BAT1.P$1 (+), T3.3 (D); also elsewhere on the board
GND: BAT1.P$3 (-), C1.1, C2.1, C3.1, C4.2, C5.2, C6.1, C7.2, C8.2, C9.2, C10.2, C11.2, C12.2, C15.-, D1.2 (ANODE), IC1.3 (GND), IC1.5 (GND), IC1.21 (AGND), IC2.2 (GND), LCD1.P$4 (R/W), LCD1.P$6 (D0), LCD1.P$7 (D1), LCD1.P$8 (D2), LCD1.P$9 (D3), LCD1.P$14 (GND), R9.2, R11.1, R15.P$E (E), R16.1, R17.1, R18.1, R20.2, T1.2 (E), T2.2 (S), X1.5 (GND), X6.P$6 (6); also elsewhere on the board
MISO: IC1.16 (PB4(MISO/PCINT4)), R5.1, X6.P$1 (1)
MOSI: IC1.15 (PB3(MOSI/OC2A/PCINT3)), R4.1, X6.P$4 (4)
unnamed: IC1.30 (PD0(RXD/PCINT16)), LCD1.P$10 (D4)
unnamed: IC1.31 (PD1(TXD/PCINT17)), LCD1.P$11 (D5)
unnamed: IC1.32 (PD2(INT0/PCINT18)), LCD1.P$12 (D6)
unnamed: IC2.4 (VFB), R8.1, R9.1
unnamed: D5.1 (ANODE), R20.1, SW1.P$2 (2), SW1.P$4 (4), T2.1 (G)
unnamed: C3.2, IC1.20 (AREF)
unnamed: IC1.1 (PD3(INT1/OC2B/PCINT19)), LCD1.P$13 (D7)
unnamed: IC1.9 (PD5(T1/OC0B/PCINT21)), LCD1.P$5 (E)
unnamed: IC1.12 (PB0(ICP1/CLKO/PCINT0)), R1.1
unnamed: C1.2, IC1.7 (PB6(XTAL1/TOSC1/PCINT6)), Q1.2
unnamed: C2.2, IC1.8 (PB7(XTAL2/TOSC2/PCINT7)), Q1.1
unnamed: IC1.13 (PB1(OC1A/PCINT1)), R2.1
unnamed: IC1.14 (PB2(SS/OC1B/PCINT2)), R3.1
unnamed: R19.1, T1.1 (B)
unnamed: IC2.3 (EN), R18.2, T5.3 (D)
unnamed: IC1.2 (PD4(T0/XCK/PCINT20)), LCD1.P$3 (RS)
unnamed: IC2.1 (SW), L1.2
unnamed: IC1.28 (PC5(ADC5/SCL/PCINT13)), R10.1, R11.2
unnamed: LCD1.P$2 (CONTR), R15.P$S (S)
unnamed: IC1.11 (PD7(AIN1/PCINT23)), R13.1, T2.3 (D)
unnamed: R12.1, T1.3 (C), T5.1 (G)
unnamed: D1.1 (KATHODE), IC1.27 (PC4(ADC4/SDA/PCINT12)), R14.1
PAD1: C7.1, C10.1, IC1.23 (PC0(ADC0/PCINT8)), R1.2, R2.2, X2.1, X9.P$1 (1)
PAD2: C8.1, C11.1, IC1.24 (PC1(ADC1/PCINT9)), R3.2, R4.2, X7.1, X9.P$2 (2)
PAD3: C9.1, C12.1, IC1.25 (PC2(ADC2/PCINT10)), R5.2, R6.2, X8.1, X9.P$3 (3)
PD6: D5.3 (KATHODE), IC1.10 (PD6(AIN0/OC0A/PCINT22)), R16.2, R19.2
SCK: IC1.17 (PB5(SCK/PCINT5)), R6.1, X6.P$3 (3)
SEG1: TP1.P$1, TP4.P$1, X4.P$1, X11.P$1
SEG2: TP2.P$1, TP5.P$1, X5.P$1, X12.P$1
SEG3: TP3.P$1, TP6.P$1, X3.P$1, X10.P$1
SEROUT: IC1.26 (PC3(ADC3/PCINT11)); also elsewhere on the board
SUP_UART: D2.3 (A1/K2); also elsewhere on the board
USBDM: X1.2 (D-); also elsewhere on the board
USBDP: X1.3 (D+); also elsewhere on the board
VCC: D2.1 (A2), R17.2, T3.1 (G), X1.1 (VCC); also elsewhere on the board
VI: C4.1, D2.2 (K1), IC2.6 (VI), L1.1, R10.2, R12.2, SW1.P$1 (1), SW1.P$3 (3), T3.2 (S), T5.2 (S)

Notes on the sheet:
Bauteiltester
Knopfzelle
CR2032
Bedienteil
Supply-Netze:
+5V = Spannungsregler-Ausgang
VCC = 5V vom USB
VI = Spannungsregler-Eingang
BAT+ = 3V von Lithiumzelle
Reserve
K.-H. Kübbeler, DF3DCB, DH8GHH

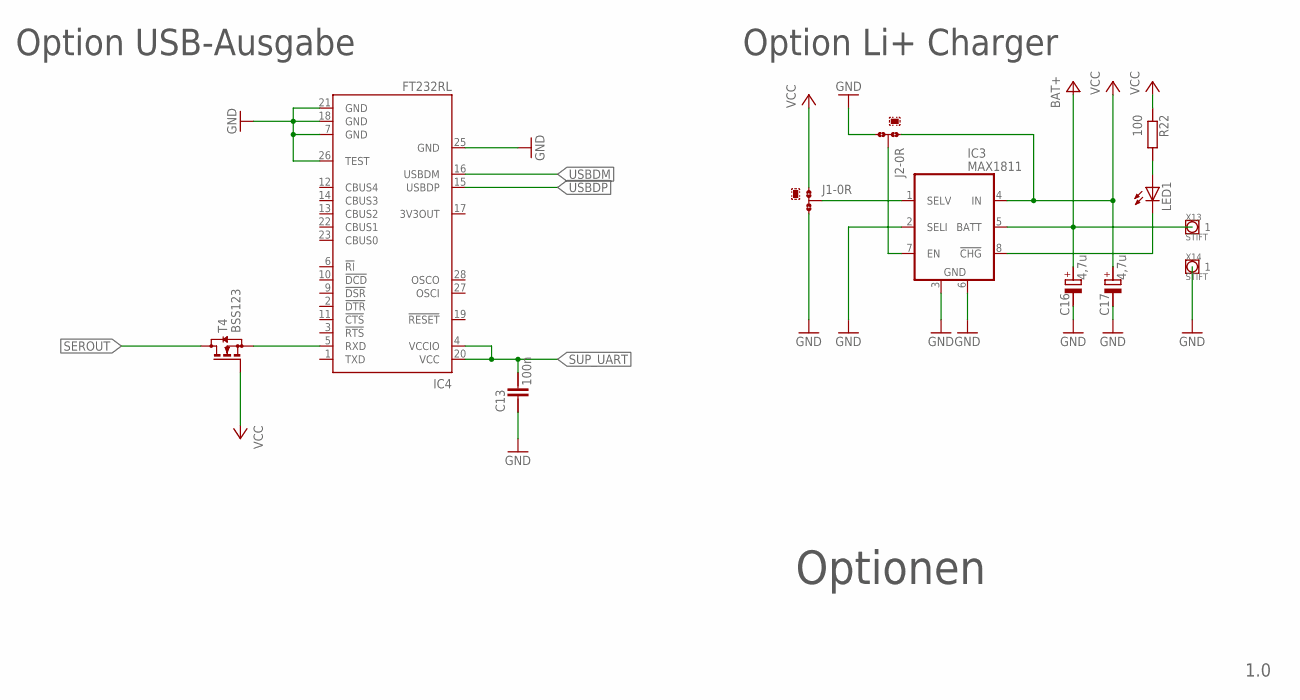
[picture p130: schematic bauteiltester.sch, sheet 2]

Parts:
C13: 100n; C0805
C16, C17: 4,7u; C-TAN_A
IC3: MAX1811; SO08
IC4: FT232RL; SSOP28
J1, J2: 0R-JUMPA; A0R-JMP
LED1: LEDCHIP-LED0805; CHIP-LED0805
R22: 100; R0805
T4: BSS123; SOT23
X13, X14: STIFT

Connections:
BAT+: C16.+ (PLUS), IC3.5 (BATT), X13.1; also elsewhere on the board
GND: C13.1, C16.- (MINUS), C17.- (MINUS), IC3.2 (SELI), IC3.3 (GND), IC3.6 (GND1), IC4.7 (GND), IC4.18 (GND), IC4.21 (GND), IC4.25 (GND), IC4.26 (TEST), J1.3, J2.3, X14.1; also elsewhere on the board
unnamed: IC3.7 (EN), J2.2
unnamed: IC3.1 (SELV), J1.2
unnamed: IC3.8 (!CHG), LED1.C
unnamed: LED1.A, R22.2
unnamed: IC4.5 (RXD), T4.2 (S)
SEROUT: T4.3 (D); also elsewhere on the board
SUP_UART: C13.2, IC4.4 (VCCIO), IC4.20 (VCC); also elsewhere on the board
USBDM: IC4.16 (USBDM); also elsewhere on the board
USBDP: IC4.15 (USBDP); also elsewhere on the board
VCC: C17.+ (PLUS), IC3.4 (IN), J1.1, J2.1, R22.1, T4.1 (G); also elsewhere on the board

Notes on the sheet:
Optionen
Option USB-Ausgabe
Option Li+ Charger

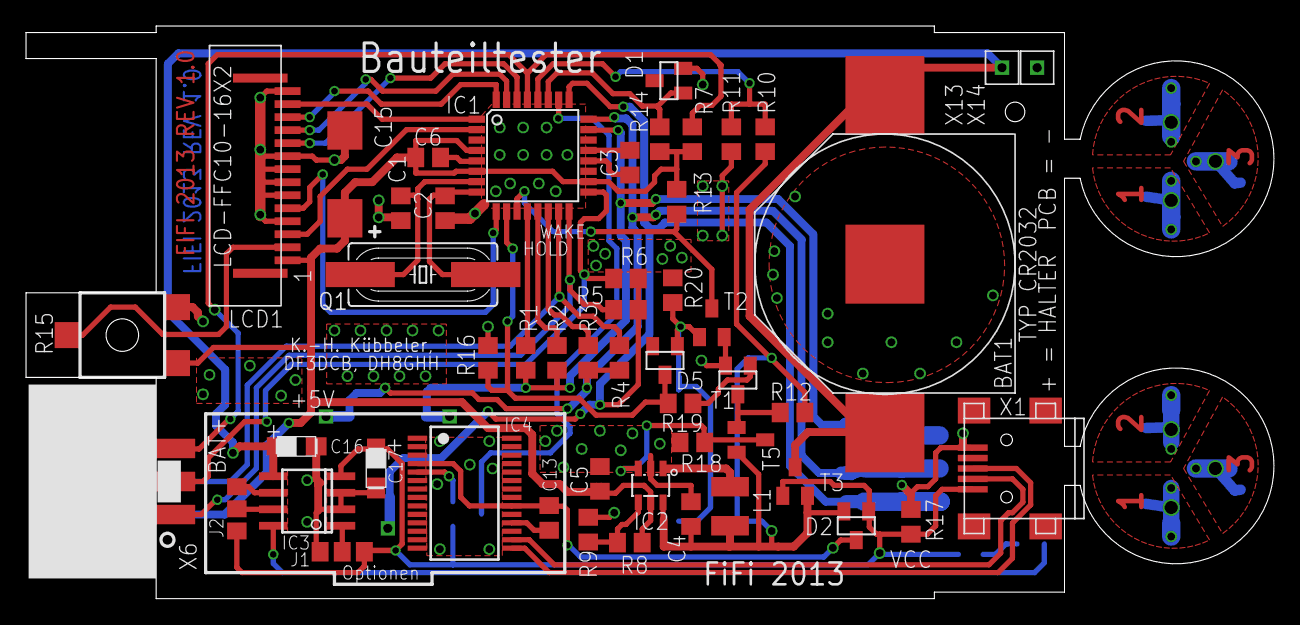
[picture p131: board bauteiltester.brd from above]

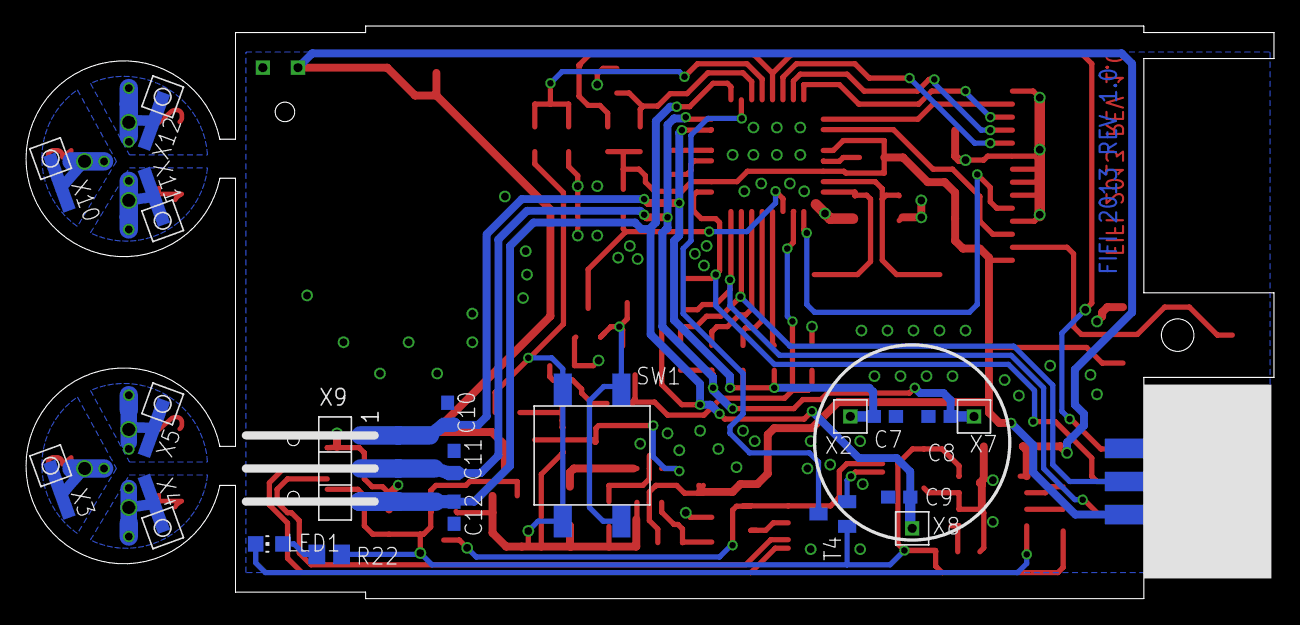
[picture p132: board bauteiltester.brd from below]

Board: 2 copper layers, 95.9 x 44.0 mm, 77 parts (26 on the bottom side), 47 nets.
