kitspace/component_tester/software/sampling_lc.c

// original June-Sept 2015, pa3fwm@amsat.org

#ifdef SamplingADC

#include "Transistortester.h"
#include <avr/io.h>
#include <stdlib.h>

// The PeakSearchMethod=0 tries to avoid the detection of the initial peak.
// Therefore the flag sawzero is set to 0 at start and the detection is
// additionally
// blocked until the seak index ii has reached a value of more than 4*dist.
// The PeakSearchMethod=1 allow the detection of the initial peak.
// The flag sawzero is set to 1 at start, but the detected first peak is never
// taking into account.
// Therefore 3 detected peaks are required to build one period in this mode.

#define PeakSearchMethod 0

typedef uint8_t byte;

uint32_t lc_fx; // measured resonant frequency (in Hz)
uint16_t lc_qx; // measured resonance Q (in units of 0.1)
uint32_t lc_lx; // measured inductance using the samplingADC method (in nH)
uint16_t lc_cpartmp;
#ifndef CxL
#define CxL                                                                    \
  18040 // default value for parallel capacitor for inductance measurement
#endif
const uint16_t lc_cpar_ee EEMEM =
    CxL; // place for lc_cpar as calibration constant in eeprom

#ifdef DEB_SAM
void report_buf(uint16_t uu[], uint8_t ll) {
  uint16_t ii;
  for (ii = 0; ii < 255; ii += 8) {
    lcd_set_cursor(ll, 0);
    uart_newline();
    DisplayValue16(uu[ii], 0, ' ', 5);
    DisplayValue16(uu[ii + 1], 0, ' ', 5);
    DisplayValue16(uu[ii + 2], 0, ' ', 5);
    DisplayValue16(uu[ii + 3], 0, ' ', 5);
    DisplayValue16(uu[ii + 4], 0, ' ', 5);
    DisplayValue16(uu[ii + 5], 0, ' ', 5);
    DisplayValue16(uu[ii + 6], 0, ' ', 5);
    DisplayValue16(uu[ii + 7], 0, ' ', 5);
    lcd_clear_line();
    lcd_refresh();
    wait_about100ms();
  } /* end for ii */
}
#endif

// Maxpk is maximum number of peaks to take into account
#define Maxpk 20

// define Special_dist1

static unsigned int peaksearch(unsigned int uu[], unsigned int *qptr)
// searches uu[256] for peaks, using averaging over dist samples
// writes measured Q *10 into *qptr if non-NULL
// returns measured period, with 6 bits of fraction, or 256*64 if no resonance
// found
{
  unsigned int xx;
  int delta; // difference of aa and bb sum
  int prevdelta;
  unsigned int aa;            // moving average of previous dist points
  unsigned int bb;            // moving average of next dist points
  unsigned char ii;           // index in uu[]
  unsigned char ipk;          // peak counter
  unsigned int firstpeak_sum; // height of first peak
  unsigned int prevpeak_sum;  // height of previous peak
  unsigned int sumpeak;       // sum of peaks (without initial peak)
  unsigned int firstpeak_x;   // time of first peak, with 6 bits of fraction
  unsigned int prevpeak_x;    // time of previous peak, with 6 bits of fraction
  unsigned char sawzero;      // flag: did we already encounter a zero?
  unsigned char dist;    // dist should be set automatically to about 1/4 of the
                         // detected period
  unsigned int mean_per; // average period; the (ipk>>2) provides for rounding
  unsigned int last_per; // length of last period with 6 bits of fraction
  unsigned int sum_ab;
  unsigned int rr;

  dist = 1; // begin peak search with dist=1

repeat:
  aa = 0;
  bb = 0;
  ipk = 0;           // peak counter
  firstpeak_sum = 0; // height of first peak
  prevpeak_sum = 0;  // height of previous peak
  sumpeak = 0;       // sum of peaks
  firstpeak_x = 0;   // time of first peak, with 6 bits of fraction
  prevpeak_x = 0;    // time of previous peak, with 6 bits of fraction
#if PeakSearchMethod == 1
#define MinPK 2
  sawzero = 1; // flag: did we already encounter a zero?
#else
#define MinPK 1
  sawzero = 0; // flag: did we allready encounter a growing signal?
#endif
  prevdelta = 1;
  mean_per = 256 << 6; // set period illegal
  for (ii = 0; ii < 255 - dist; ii++) {
    bb += uu[ii + dist];
    aa += uu[ii];
    if (ii < dist)
      continue;
    aa -= uu[ii - dist];
    bb -= uu[ii];
#ifdef Special_dist1
    if (dist > 1) {
#endif
      sum_ab = aa + bb;
      delta = aa - bb;
// the detection of zero is replaced by  detection of rising  (kubi)
#if PeakSearchMethod == 1
      if (((int)(sum_ab / 32) + delta) < 0)
#else
    if (((int)(sum_ab / 4) + delta) < 0)
#endif
      {
        sawzero = 1;
      }

// note: uu[] can be assumed < 600 or so, since we're not interested in peaks
// above some 600 mV
// with dist<=32 (because at least 2 periods must fit in 256 samples)
// this means a and b cannot exceed about +20000, and cannot be negative
// delta is between -20000 and 20000; near zero crossing delta can't exceed one
// uu[] value, i.e. +/- 600
// delta can therefore safely be shifted <<6, but not <<8
// hence the 6 bits of fraction in the peak location
// on my atmega328p, in some cases most measured peak intervals differ by less
// than about 0.05, so 6 bits of fraction is just enough to not lose precision

//        if ((ipk < 2) && (ii > 160)) break;	// no chance to find a period
#ifdef Special_dist1
    } else {
      // this method gives better interpolation of the peak location (fraction
      // of ii)
      // but find too many peaks in case of slow voltage change with noise
      sum_ab = aa + bb + uu[ii - dist]; // bb is uu[ii+dist], aa is uu[ii]
      delta = uu[ii - dist] - bb;
      sawzero = (aa > uu[ii - dist]);
    }
#endif

    if ((bb < aa) && (sawzero == 1)) {
      // found (local) maximum
      xx = (ii << 6);
      //         xx -=  ((delta<<6)+(1<<5))/(delta-prevdelta);
      // (delta - prevdelta) is same as ((2*uu[ii]) - uu[ii-dist] - uu[ii+dist])
      // For a correct size of delta the uu[ii-dist] and uu[ii+dist] are low
      // against 2*uu[ii].
      // By dividing with 2*uu[ii] alone, the interpolation can be used with
      // dist=1.
      uint16_t kdiv;
      //         kdiv = 2 * uu[ii];
      kdiv = delta - prevdelta;
#if PeakSearchMethod == 1
      if (kdiv >= delta)
        xx -= (((long)delta * 64) + 32) / kdiv;
#else
      if (kdiv >= delta)
        xx -= ((delta * 64) + 32) / kdiv;
#endif

#if PeakSearchMethod == 1
      if (ipk != 0)
#endif
      {
        if (sum_ab < (3 * dist))
          break; // stop if peak not significantly high
#if PeakSearchMethod == 1
        if (ipk == 1)
#else
        if (ii < (dist * 4))
          goto illegal_peak;
        if (ipk == 0)
#endif
        {
          firstpeak_sum = sum_ab;     // amplitude sum of first peak
          firstpeak_x = xx;           // position of first peak
        } else {                      // ipk > 1
          last_per = xx - prevpeak_x; // length of last period
          if ((ipk > (MinPK + 1)) &&
              (last_per > (mean_per + mean_per / 2 + 32)))
            break; // gap between peaks
          // sanity check: distance between peaks is expected to be 4*dist
          // samples
          unsigned char smp_per;
          smp_per = last_per >> 8; // period with 4 sample units
          if (smp_per >
              dist) { // dist is lower than 1/4 period without rounding
            dist = smp_per + 1; // set dist to the found period / 4, rounded up
            goto repeat;
          }
        }                  /* ipk > 1 */
        sumpeak += sum_ab; // build sum of amplitude
#if (DEB_SAM == 5)
        if (qptr) { /* report only the final peaks */
          lcd_set_cursor(6, 0);
          uart_newline();
          lcd_data('i');
          lcd_data('=');
          DisplayValue(ii, 0, ' ', 3);
          DisplayValue(sumpeak, 0, '=', 5);
          DisplayValue(aa, 0, '+', 5);
          DisplayValue(bb, 0, ' ', 5);
          lcd_set_cursor(7, 0);
          uart_newline();
          wait_about500ms();
        }
#endif
      }                      /* ipk != 0 */
      prevpeak_sum = sum_ab; // save amplitude of last peak
      prevpeak_x = xx;       // save position of last peak
      ipk++;                 // one more peak found
      if (ipk > MinPK) {
        mean_per = (prevpeak_x - firstpeak_x + ((ipk - MinPK) >> 1)) /
                   (ipk - MinPK); // average period with rounding
      }
#if PeakSearchMethod != 1
    illegal_peak:
#endif
      sawzero = 0;
      if (ipk > Maxpk)
        break; // count of requested peaks is found
    }          /* end found maximum */
    prevdelta = delta;
  } /* end for ii */

  /* total data are analysed, ipk is now the count of peaks + 1 */
  //   if (firstzero>(per>>6)) return 0;     // sanity check: first zero should
  //   be within first period
  if (qptr) {
    // calculate r = ratio of amplitude between two consecutive peaks (*1000 for
    // scaling)
    // but we use all peaks seen in this calculation for better accuracy
    // r is weighted average of peak2/peak1, peak3/peak2 and so on, weighed by
    // respectively peak1, peak2 and so on
    // this can be calculated as r =
    // (peak2+peak3+...+peak_m)/(peak1+peak2+peak_{m-1})
    rr = 0;
    if (ipk > MinPK) {
      unsigned int sumdiff = sumpeak - prevpeak_sum;
      rr = ((unsigned long)(sumpeak - firstpeak_sum) * 1000) / sumdiff;
      // rr = exp(-pi/Q)  so Q = -pi/(ln(rr))
      // for r almost 1 (i.e., high Q), this is approx. pi/(1-rr)
      rr = 31416u / get_log(1000 - rr);
      // note scaling: the get_log is *1000, and we now compute Q in multiples
      // of .1, hence the numerator being 10000*pi
    }
    *qptr = (unsigned int)rr;
  }
#if DEB_SAM == 11
  if (qptr)
    lcd_set_cursor(7, 0);
  else
    lcd_set_cursor(6, 0);
  uart_newline();
  lcd_data('p');
  lcd_data('=');
  DisplayValue(ipk, 0, ' ', 3);
  DisplayValue(((unsigned long)mean_per * 25) / 16, -2, ' ', 6);
  DisplayValue(dist, 0, ' ', 5);
#endif
  return mean_per;
} /* end of peaksearch */
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
