kitspace/component_tester/software/show_Resis_Cap.c

// show_Resis_Cap.c , new code by K.-H. Kübbeler

#include "Transistortester.h"
#include <avr/io.h>
#include <stdlib.h>

typedef uint8_t byte;

// display formats for R, L, and resonance measurement:
// |....|....|....|   (16 characters line length)

// nothing found:
// 1-RR-3      [RL]
// ?

// only resistance:
// 1-RR-3      [RL]
// 12.34kO

// resistance and inductance
// 1-RR-LL-3   [RL]
// 12.34kO L=12.3uH
// 334.5kHz Q=12.3    <--- only  if resonance detected

// resistance and inductance measured through resonance, rather tight format to
// fit on 3 lines
// 1-RR-LL-3 12.34kO   (the ohm sign doesn't fit this way, but most likely,
// there's no 'k' sign since coils tend to not have that much resistance)
// 12.3uH if 22.0nF
// 334.5kHz Q=12.3

// same case but on bigger screens:  <---- not yet implemented!
// 1-RR-LL-3
// 12.34kO
// 12.3uH if 22.0nF
// 334.5kHz Q=12.3

#if FLASHEND > 0x1fff

#if FLASHEND > 0x3fff
// EXTRASPACES contains any extra spaces needed to fill out the line if wider
// than 16 characters, i.e., LCD_LINE_LENGTH-16 spaces
#if LCD_LINE_LENGTH == 16
#define EXTRASPACES
#elif LCD_LINE_LENGTH == 17
#define EXTRASPACES ' ',
#elif LCD_LINE_LENGTH == 18
#define EXTRASPACES ' ', ' ',
#elif LCD_LINE_LENGTH == 19
#define EXTRASPACES ' ', ' ', ' ',
#elif LCD_LINE_LENGTH == 20
#define EXTRASPACES ' ', ' ', ' ', ' ',
#elif LCD_LINE_LENGTH == 21
#define EXTRASPACES ' ', ' ', ' ', ' ', ' ',
#elif LCD_LINE_LENGTH == 22
#define EXTRASPACES ' ', ' ', ' ', ' ', ' ', ' ',
#elif LCD_LINE_LENGTH == 23
#define EXTRASPACES ' ', ' ', ' ', ' ', ' ', ' ', ' ',
#elif LCD_LINE_LENGTH == 24
#define EXTRASPACES ' ', ' ', ' ', ' ', ' ', ' ', ' ', ' ',
#elif LCD_LINE_LENGTH == 25
#define EXTRASPACES ' ', ' ', ' ', ' ', ' ', ' ', ' ', ' ', ' ',
#elif LCD_LINE_LENGTH == 26
#define EXTRASPACES ' ', ' ', ' ', ' ', ' ', ' ', ' ', ' ', ' ', ' ',
#elif LCD_LINE_LENGTH == 27
#define EXTRASPACES ' ', ' ', ' ', ' ', ' ', ' ', ' ', ' ', ' ', ' ', ' ',
#elif LCD_LINE_LENGTH == 28
#define EXTRASPACES ' ', ' ', ' ', ' ', ' ', ' ', ' ', ' ', ' ', ' ', ' ', ' ',
#elif LCD_LINE_LENGTH == 29
#define EXTRASPACES                                                            \
  ' ', ' ', ' ', ' ', ' ', ' ', ' ', ' ', ' ', ' ', ' ', ' ', ' ',
#elif LCD_LINE_LENGTH == 30
#define EXTRASPACES                                                            \
  ' ', ' ', ' ', ' ', ' ', ' ', ' ', ' ', ' ', ' ', ' ', ' ', ' ', ' ',
#elif LCD_LINE_LENGTH == 31
#define EXTRASPACES                                                            \
  ' ', ' ', ' ', ' ', ' ', ' ', ' ', ' ', ' ', ' ', ' ', ' ', ' ', ' ', ' ',
#elif LCD_LINE_LENGTH == 32
#define EXTRASPACES                                                            \
  ' ', ' ', ' ', ' ', ' ', ' ', ' ', ' ', ' ', ' ', ' ', ' ', ' ', ' ', ' ',   \
      ' ',
#elif LCD_LINE_LENGTH == 33
#define EXTRASPACES                                                            \
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
