kitspace/component_tester/(commit log)

2018-04-19 Work on schematic
    [component_tester.kicad_pcb, component_tester.sch]
2018-04-19 Schema schemaaa
    [component_tester.sch]
2018-04-19 Move hardware into kicad dir
    [component_tester.kicad_pcb, component_tester.sch]
2018-04-27 Start panelizing
    [component_tester.kicad_pcb, component_tester.sch]
2018-04-28 Work on drills
2018-04-28 Start working on pads
    [component_tester.kicad_pcb]
2018-04-28 Try out button and add logo
    [component_tester.kicad_pcb]
2018-06-09 Adjust logo url
    [component_tester.kicad_pcb]
2018-06-09 Adjust logo text some more
    [component_tester.kicad_pcb]
2018-06-09 Import eagle project from o28 fifi bauteiltester
    [component_tester.kicad_pcb, component_tester.sch, component_tester_1.sch, component_tester_2.sch]
2018-06-09 Add drawings back into pcb
    [component_tester.kicad_pcb, component_tester.sch, component_tester_1.sch, component_tester_2.sch]
2018-06-10 Fix some schematic eagle import oddities
    [component_tester.kicad_pcb, component_tester_1.sch]
2018-06-13 Switch resistors and caps to 0201 where possible
    [component_tester.kicad_pcb, component_tester_1.sch, component_tester_2.sch]
2018-06-14 Switch atemega to smaller footprint
    [component_tester_1.sch]
2018-06-14 Switch battery holder footprint
    [component_tester.kicad_pcb, component_tester_1.sch]
2018-06-14 Add OLED footprint
    [component_tester.kicad_pcb, component_tester_1.sch]
2018-06-14 Add test pads bottom footprint
    [component_tester.kicad_pcb]
2018-06-14 Connect up test pads
    [component_tester.kicad_pcb, component_tester.sch, component_tester_1.sch]
2018-06-14 Sort out ground net
    [component_tester.kicad_pcb, component_tester.sch, component_tester_1.sch, component_tester_2.sch]
2018-06-14 Remove all the ground labels and zones
    [component_tester.kicad_pcb, component_tester.sch, component_tester_1.sch]
2018-06-14 Remove all vias
    [component_tester.kicad_pcb, component_tester_1.sch]
2018-06-14 Sort out power nets/labels
    [component_tester.kicad_pcb, component_tester_1.sch, component_tester_2.sch]
2018-06-15 Import Adafruit OLED breakout
    [component_tester.kicad_pcb, component_tester.sch, component_tester_1.sch, component_tester_2.sch, component_tester_3.sch]
2018-06-15 Switch 0201 footprints for 0402
    [component_tester.kicad_pcb, component_tester_1.sch, component_tester_2.sch, component_tester_3.sch]
2018-06-15 Switch out crystal oscillator footprint
    [component_tester.kicad_pcb]
2018-06-15 Switch button footprint
    [component_tester.kicad_pcb, component_tester_1.sch, component_tester_2.sch, component_tester_3.sch]
2018-06-15 Flip the board and begin placing
    [component_tester.kicad_pcb]
2018-06-15 Use hierplace to re-arrange footprints
    [component_tester.kicad_pcb]
2018-06-15 Continue placing
    [component_tester.kicad_pcb]
2018-06-15 Change USB footprint
    [component_tester.kicad_pcb, component_tester_1.sch]
2018-06-15 Reduce atmega decoupling cap to 10uF
    [component_tester.kicad_pcb, component_tester_1.sch]
2018-06-15 Use panasonic evq for tactile switch
    [component_tester.kicad_pcb, component_tester_1.sch]
2018-06-15 Work on placement
    [component_tester.kicad_pcb]
2018-06-15 Make all schematic references and values visible
    [component_tester_1.sch, component_tester_2.sch, component_tester_3.sch]
2018-06-15 Remove unnecessary stuff from OLED circuitry
    [component_tester.kicad_pcb, component_tester_3.sch]
2018-06-15 Add drawings of inner edges to help with layout
    [component_tester.kicad_pcb]
2018-06-16 Adjust pads placement tonot interfere with screen
    [component_tester.kicad_pcb]
2018-06-16 Work on placing components
    [component_tester.kicad_pcb, component_tester_1.sch]
2018-06-16 Switch back to 0201s and continue placing
    [component_tester.kicad_pcb, component_tester_1.sch, component_tester_3.sch]
2018-06-16 Set up design rules and test out routing a bit
    [component_tester.kicad_pcb]
2018-06-16 Do some routing
    [component_tester.kicad_pcb]
2018-06-16 Make ISP header a pogo pin one
    [component_tester.kicad_pcb, component_tester_1.sch, component_tester_3.sch]
2018-06-17 Adjust layers, make sure ISP through holes have copper
    [component_tester.kicad_pcb]
2018-06-17 Work on placing/routing
    [component_tester.kicad_pcb]
2018-06-17 Cut out precision voltage reference
    [component_tester.kicad_pcb, component_tester_1.sch]
2018-06-17 Switch some transistors for smaller footprints
    [component_tester.kicad_pcb, component_tester_1.sch]
2018-06-17 Route some more
    [component_tester.kicad_pcb]
2018-06-19 Place and route
    [component_tester.kicad_pcb]
2018-06-19 Route stuff
    [component_tester.kicad_pcb]
2018-10-08 Remove all kicad-4 schematic libs
    [component_tester.sch, component_tester_1.sch, component_tester_2.sch, component_tester_3.sch]
2018-10-08 Remove tags from eagle exported footprints
    [component_tester.kicad_pcb]
2020-09-11 Add datasheets and playground directories
    [$savepcb.brd, .kicad_pcb.kicad_pcb, BMS-dacus.brd, BMS-dacus.csv, BMS-dacus.kicad_pcb, BMS-dacus.sch, BMS-dacus2.csv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]
