kitspace/component_tester/(notices)

Notices in the files:
software/autoconf.h:
CC0 defines the capacity of empty terminal pins 1 & 3 without cable
